ycwn/yatabaza/docs/schematics/yatabaza-cpu.pdf

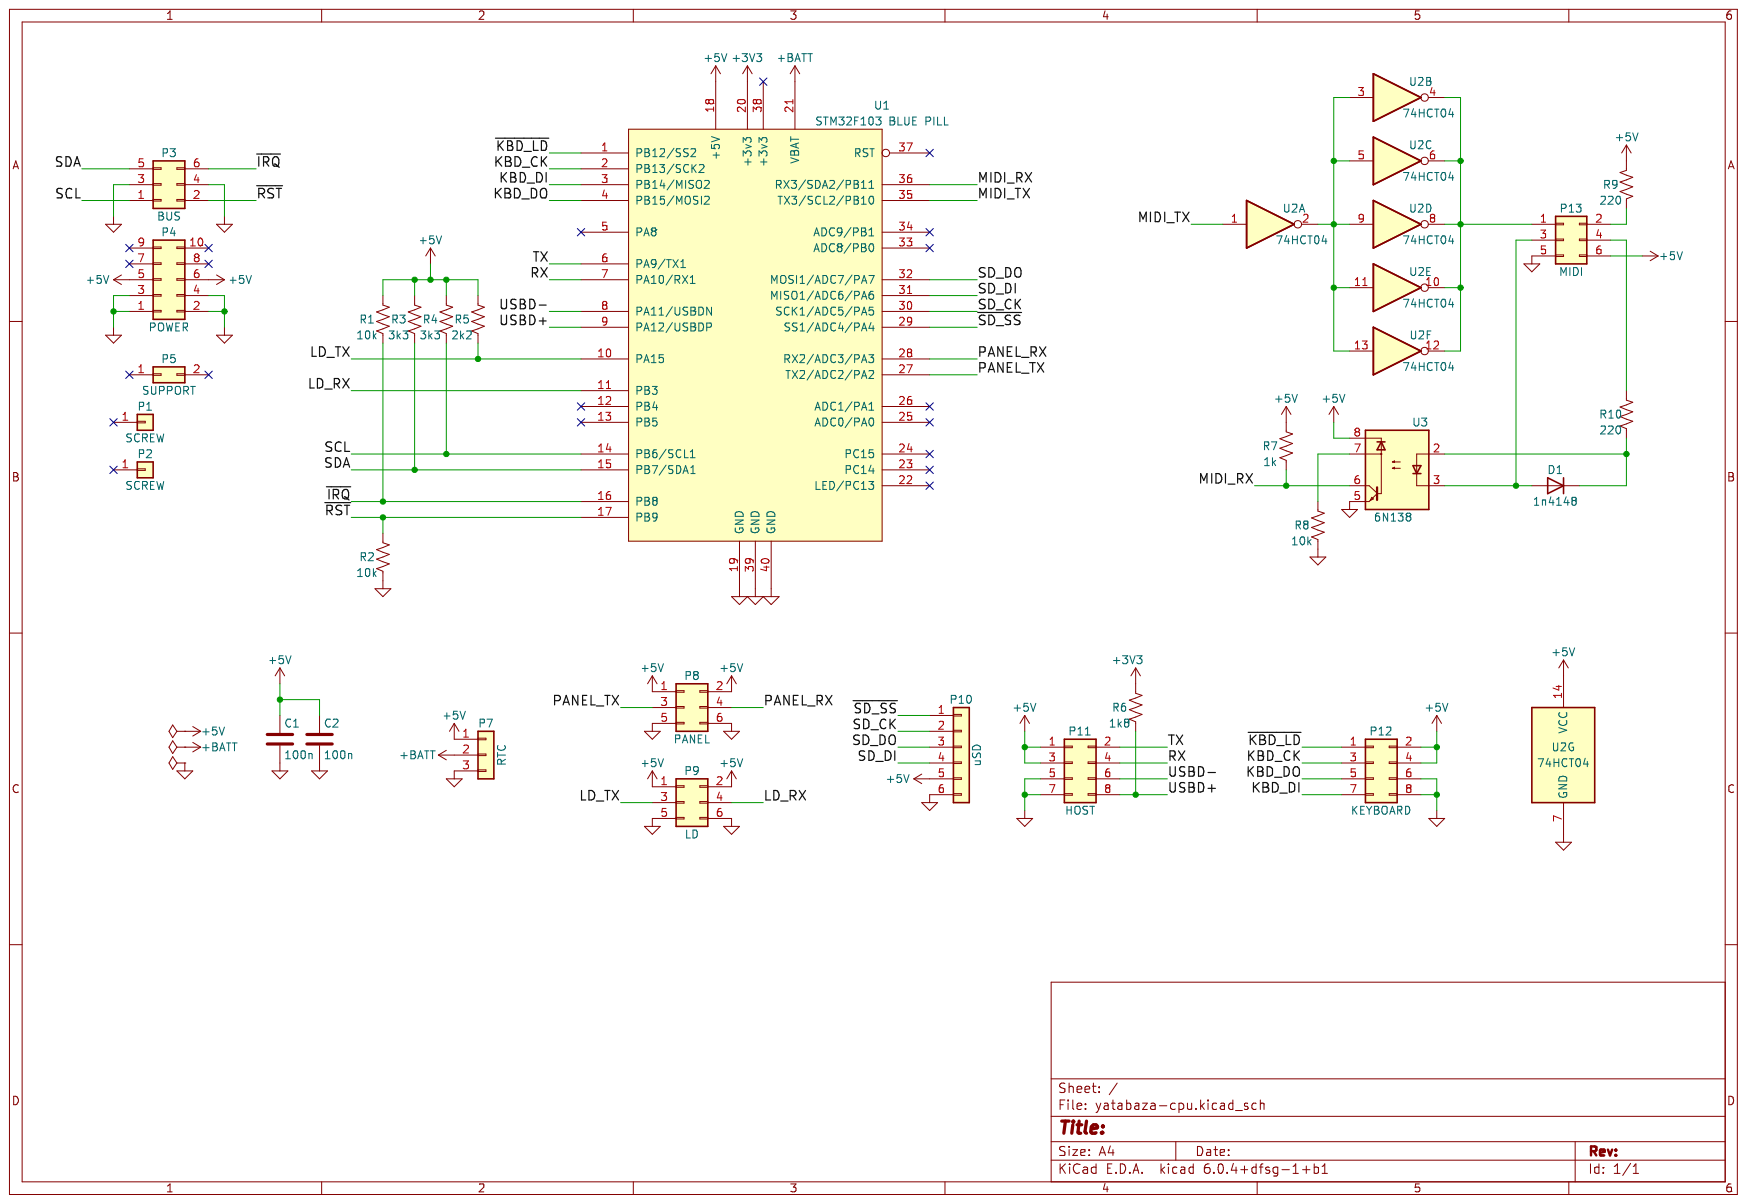
[picture p1: page 1]
