ycwn/yatabaza/docs/schematics/yatabaza-power.pdf

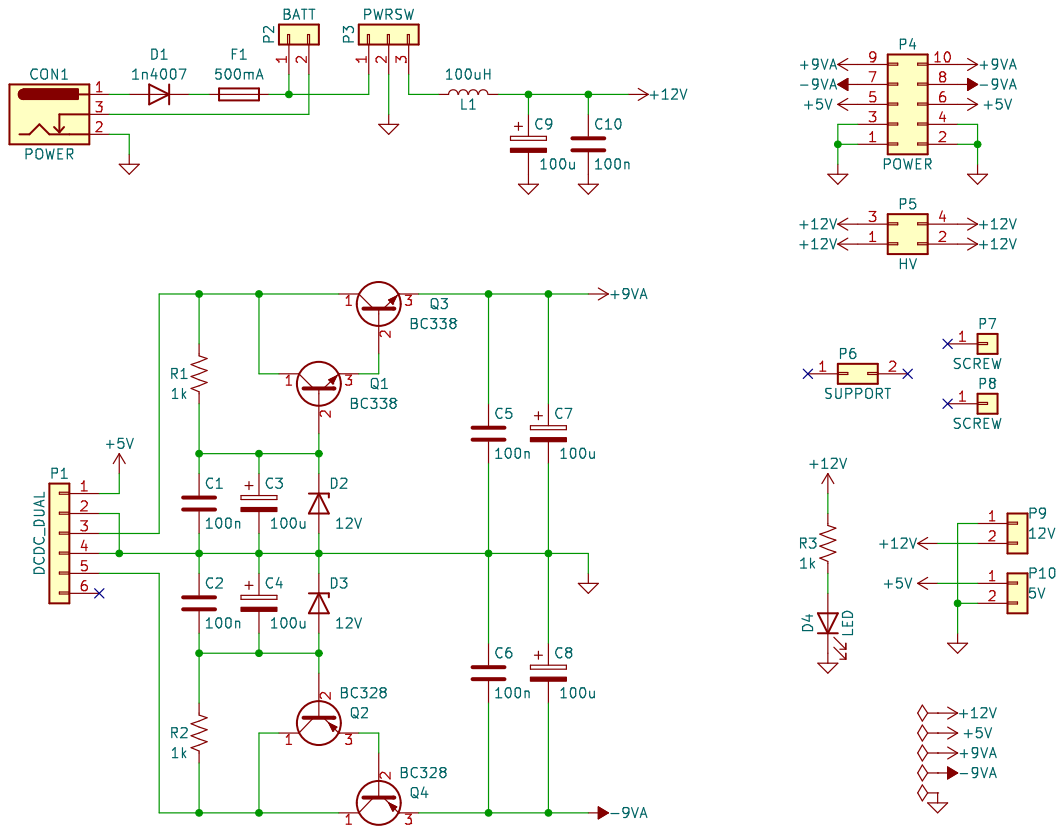
[picture p2: page 1]
