ycwn/yatabaza/docs/schematics/yatabaza-synth.pdf

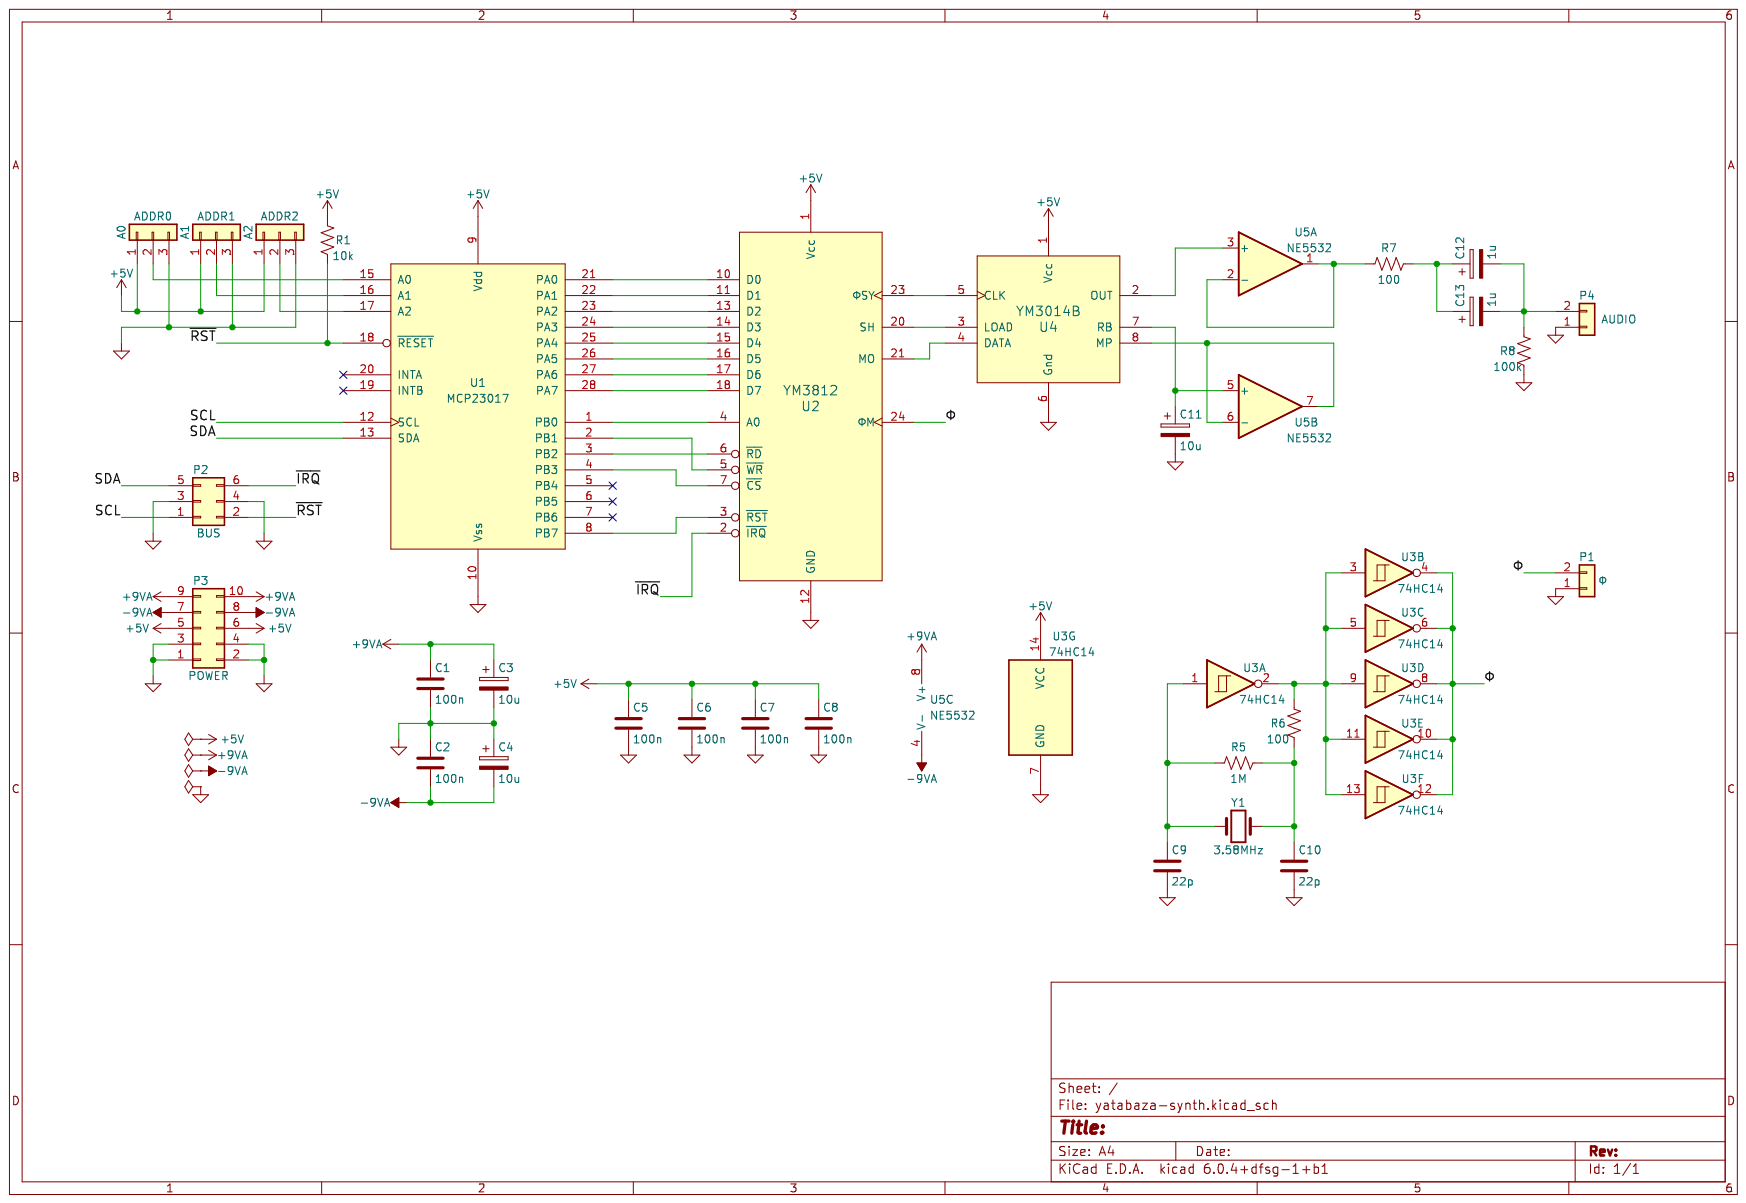
[picture p3: page 1]
