ycwn/yatabaza/docs/schematics/yatabaza-keyboard.pdf

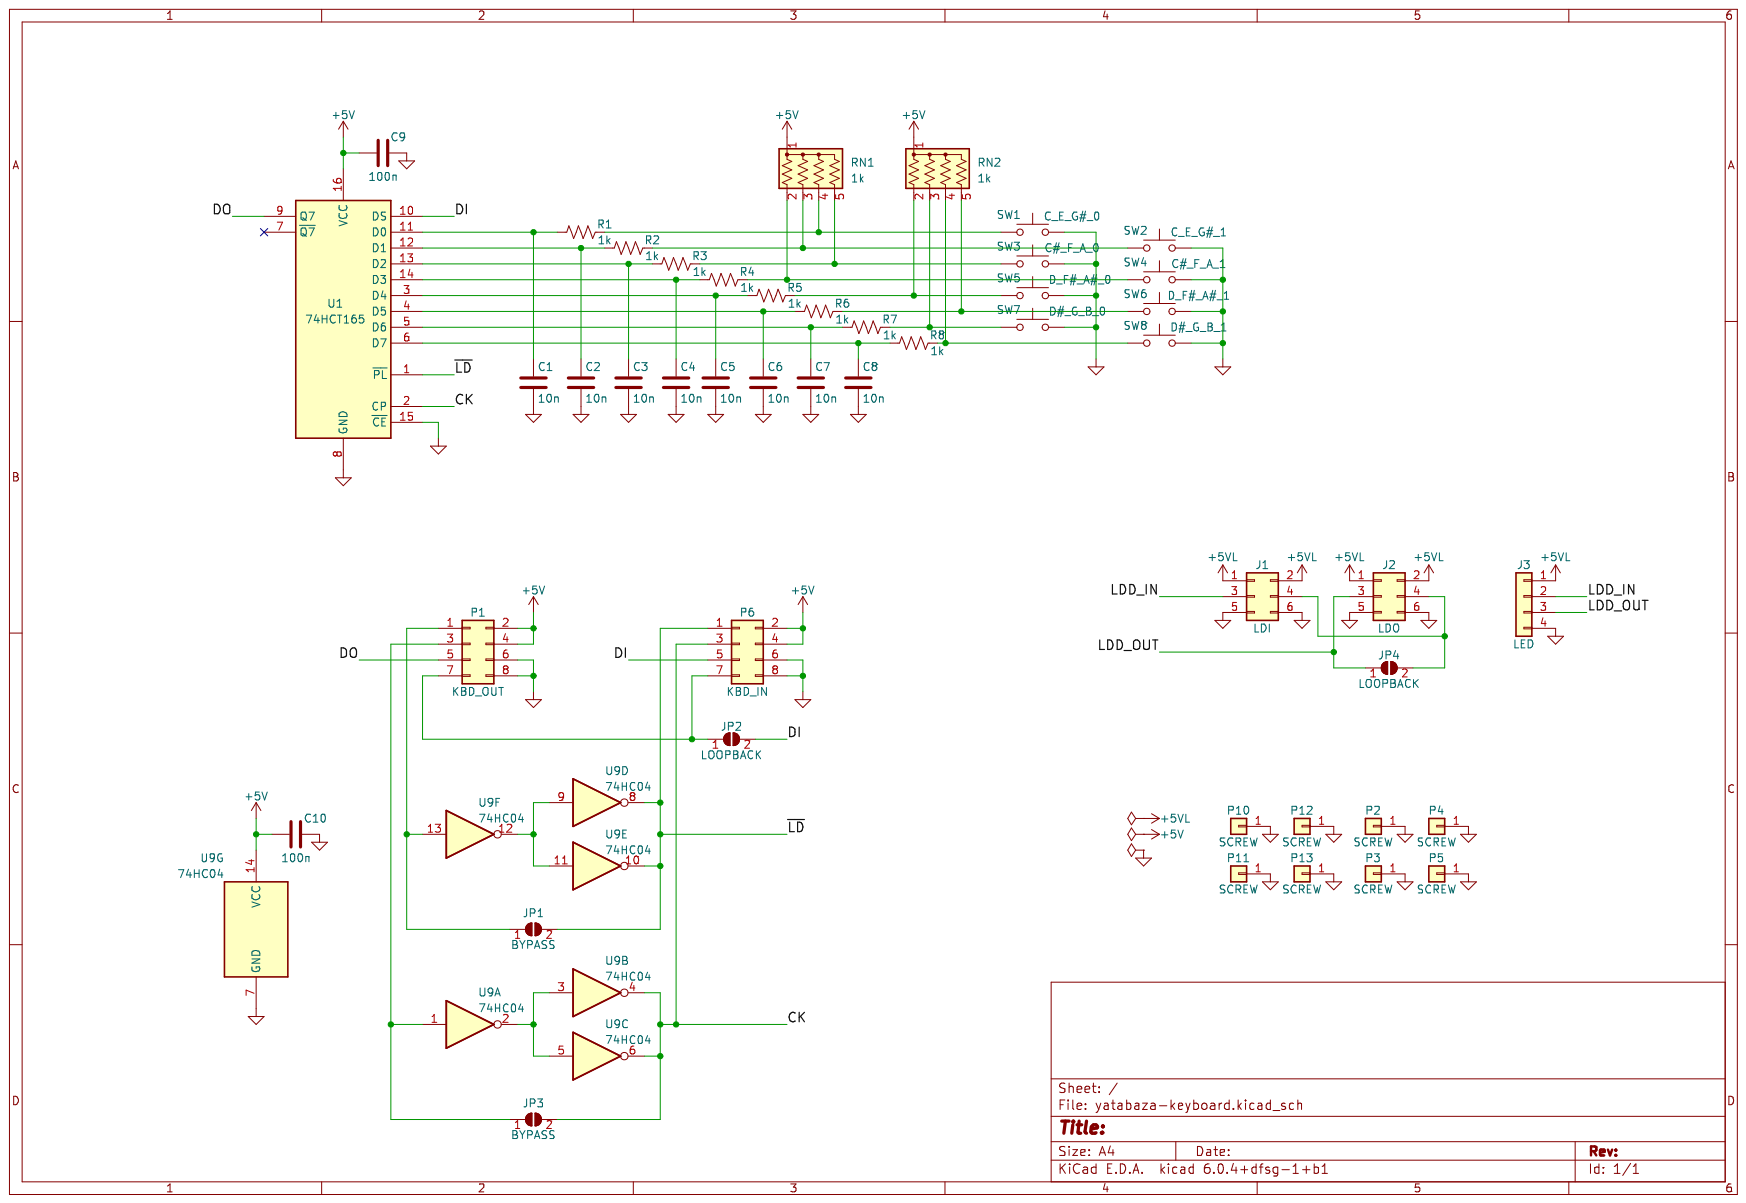
[picture p4: page 1]
