ycwn/yatabaza/docs/schematics/yatabaza-amp.pdf

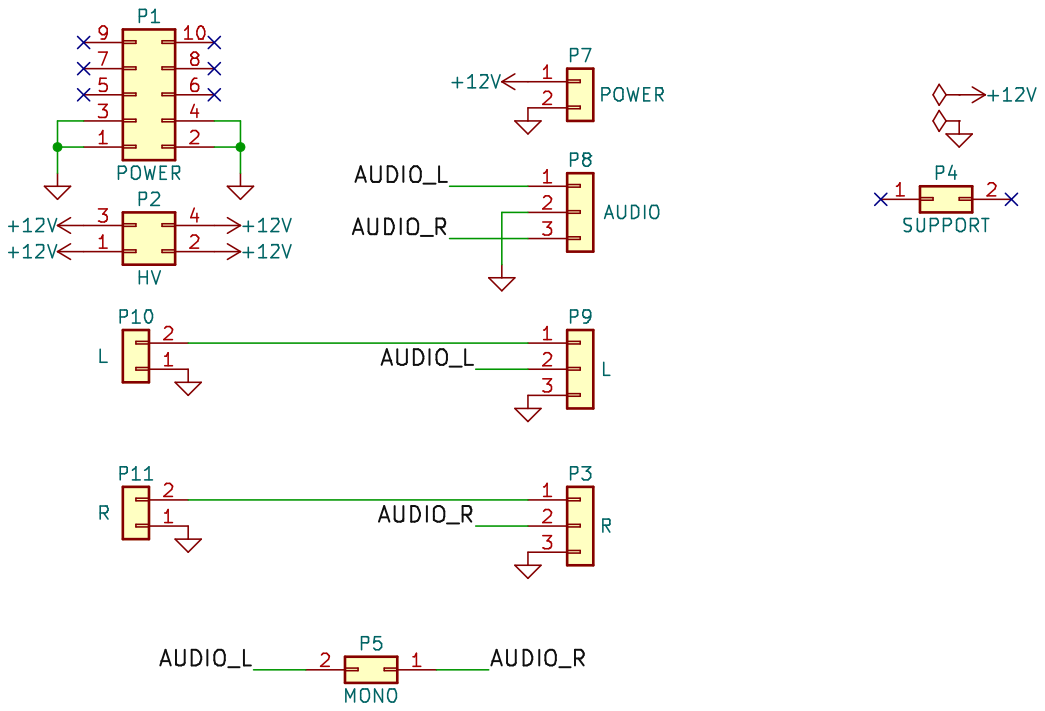
[picture p5: page 1]
