ycwn/yatabaza/docs/schematics/yatabaza-bus.pdf

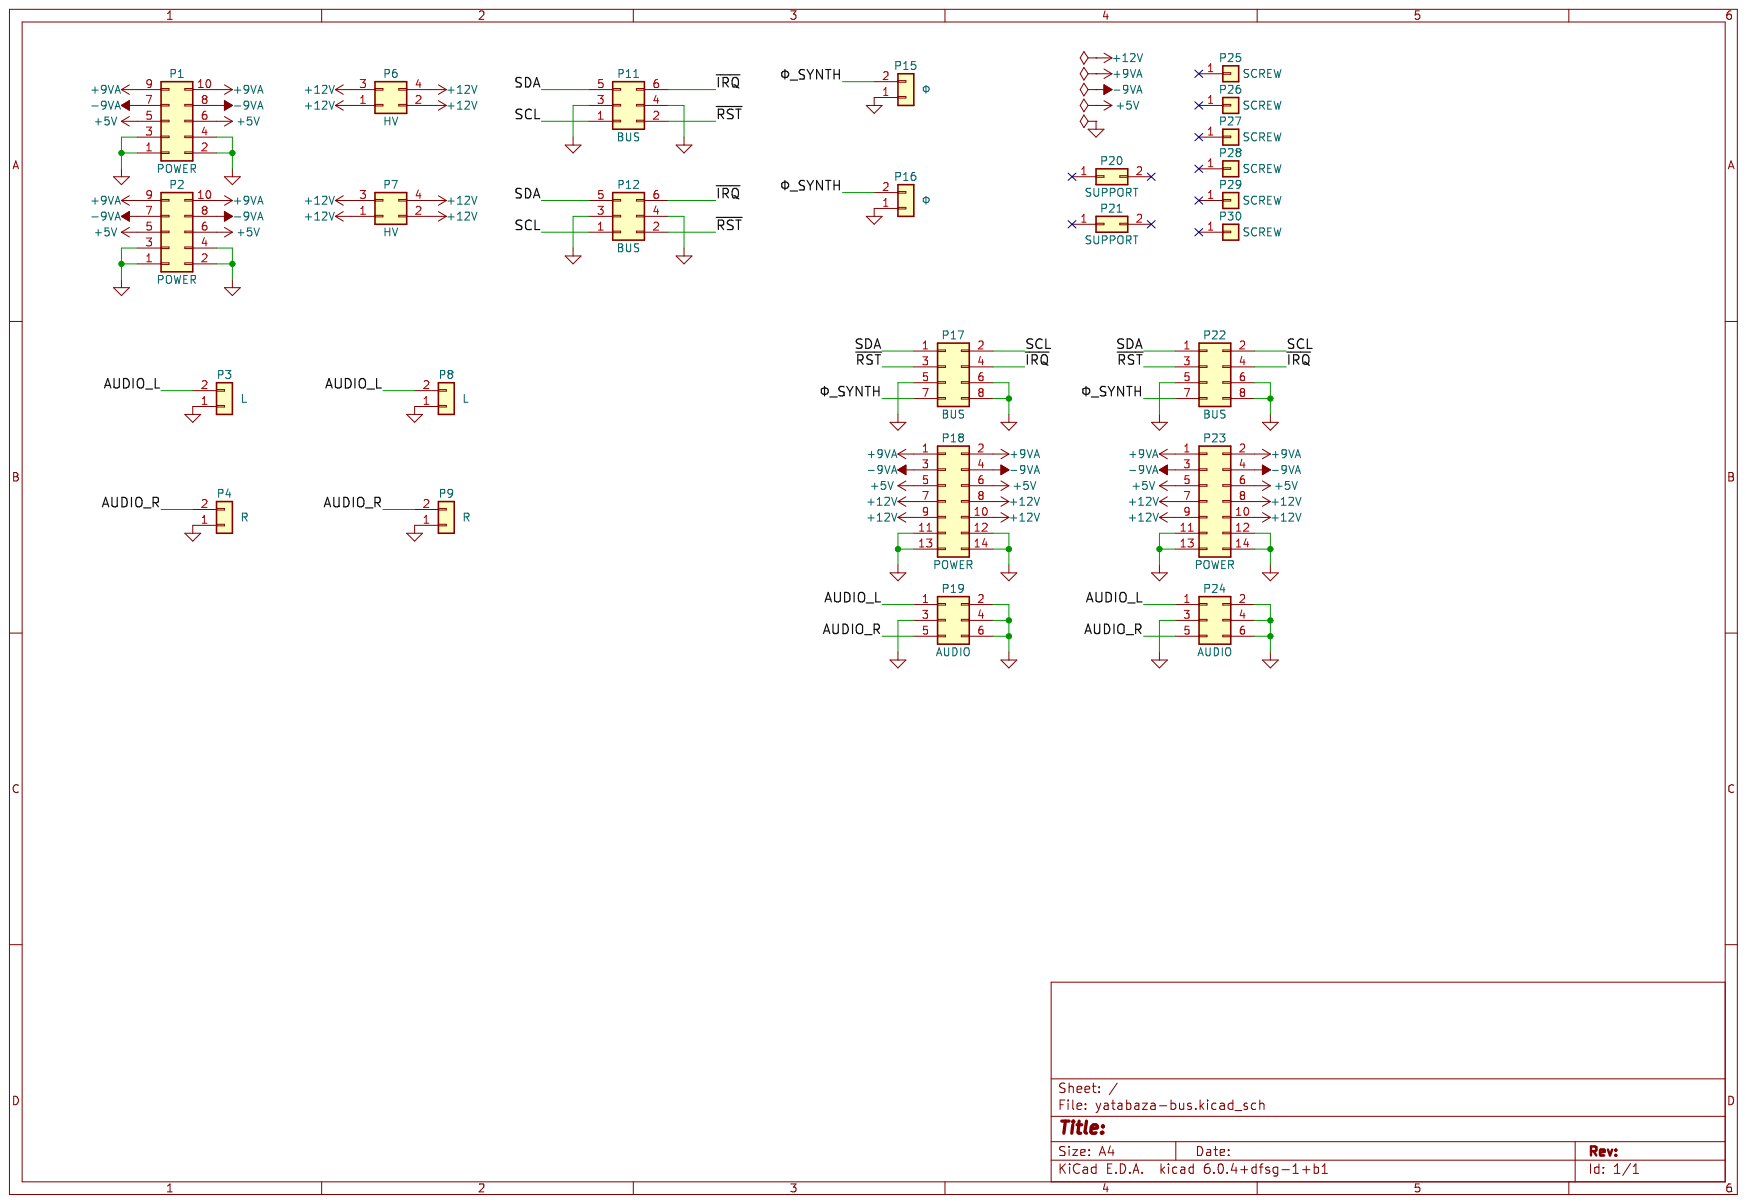
[picture p6: page 1]
