ycwn/yatabaza/hardware/keyboard/yatabaza-keyboard.kicad_pcb

## KiCad design hardware/keyboard/yatabaza-keyboard.kicad_pcb (2022-05-02)

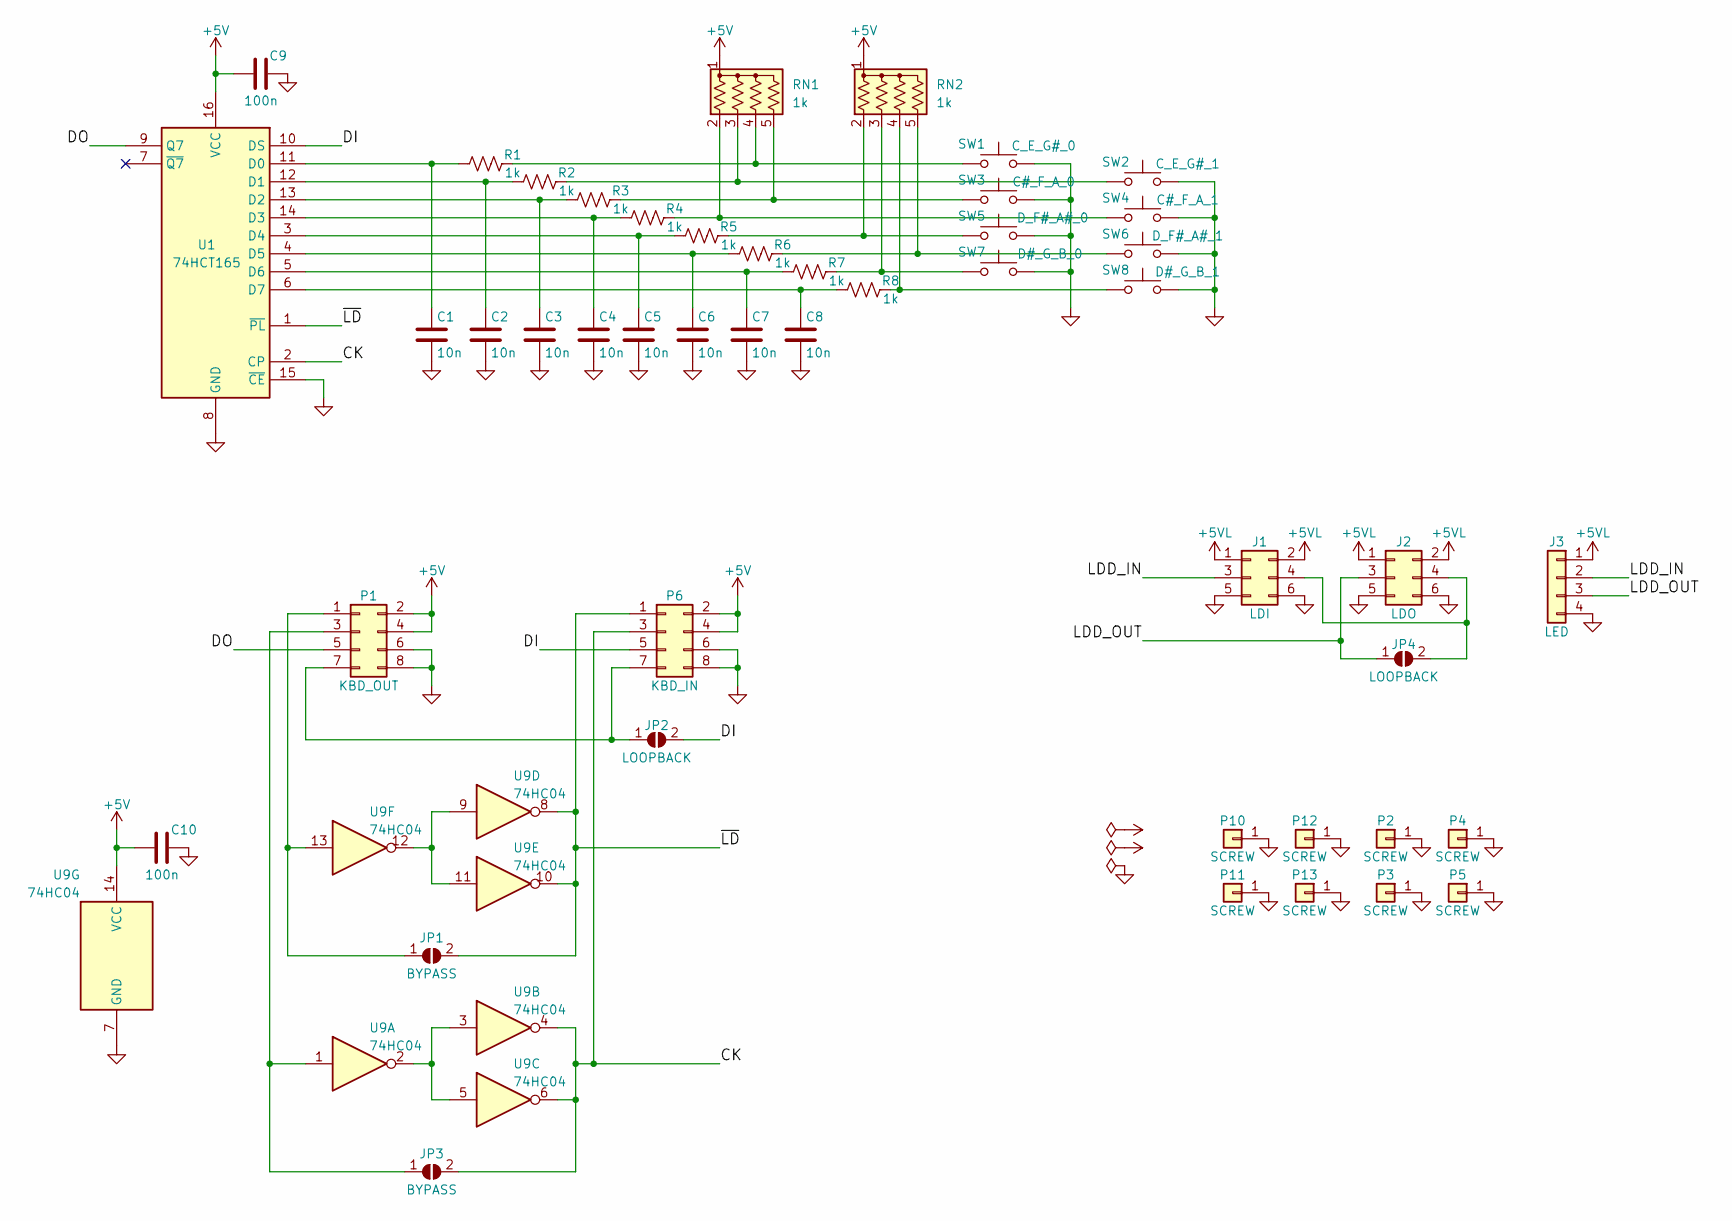
[picture p7: schematic yatabaza-keyboard.kicad_sch]

Parts:
C1, C2, C3, C4, C5, C6, C7, C8: 10n; C_Disc_D3.0mm_W1.6mm_P2.50mm
C9, C10: 100n; C_Disc_D3.0mm_W1.6mm_P2.50mm
J1: LDI; PinHeader_2x03_P2.54mm_Vertical
J2: LDO; PinHeader_2x03_P2.54mm_Vertical
J3: LED; PinHeader_1x04_P2.54mm_Vertical
JP1, JP3: BYPASS; SolderJumper-2_P1.3mm_Open_Pad1.0x1.5mm
JP2, JP4: LOOPBACK; SolderJumper-2_P1.3mm_Open_Pad1.0x1.5mm
P1: KBD_OUT; PinHeader_2x04_P2.54mm_Vertical
P2, P3, P4, P5, P10, P11, P12, P13: SCREW; MountingHole_3.5mm_Pad
P6: KBD_IN; PinHeader_2x04_P2.54mm_Vertical
R1, R2, R3, R4, R5, R6, R7, R8: 1k; R_Axial_DIN0204_L3.6mm_D1.6mm_P2.54mm_Vertical
RN1, RN2: 1k; R_Array_SIP5
SW1: C_E_G#_0; SW_PUSH-12mm
SW2: C_E_G#_1; SW_PUSH-12mm
SW3: C#_F_A_0; SW_PUSH-12mm
SW4: C#_F_A_1; SW_PUSH-12mm
SW5: D_F#_A#_0; SW_PUSH-12mm
SW6: D_F#_A#_1; SW_PUSH-12mm
SW7: D#_G_B_0; SW_PUSH-12mm
SW8: D#_G_B_1; SW_PUSH-12mm
U1: 74HCT165; DIP-16_W7.62mm
U9: 74HC04; DIP-14_W7.62mm

Connections:
+5V: C9.1, C10.1, P1.2, P1.4, P6.2, P6.4, RN1.1 (common), RN2.1 (common), U1.16 (VCC), U9.14 (VCC)
+5VL: J1.1, J1.2, J2.1, J2.2, J3.1
/CK: JP3.2 (B), P6.3, U1.2 (CP), U9.4, U9.6
/DI: JP2.2 (B), P6.5, U1.10 (DS)
/DO: P1.5, U1.9 (Q7)
/LDD_IN: J1.3, J3.2
/LDD_OUT: J2.3, J3.3, JP4.1 (A)
/~LD: JP1.2 (B), P6.1, U1.1 (~PL), U9.8, U9.10
GND: C1.2, C2.2, C3.2, C4.2, C5.2, C6.2, C7.2, C8.2, C9.2, C10.2, J1.5, J1.6, J2.5, J2.6, J3.4, P1.6, P1.8, P2.1, P3.1, P4.1, P5.1, P6.6, P6.8, P10.1, P11.1, P12.1, P13.1, SW1.1, SW2.1, SW3.1, SW4.1, SW5.1, SW6.1, SW7.1, SW8.1, U1.8 (GND), U1.15 (~CE), U9.7 (GND)
unnamed: C1.1, R1.2, U1.11 (D0)
unnamed: C2.1, R2.2, U1.12 (D1)
unnamed: C3.1, R3.2, U1.13 (D2)
unnamed: C4.1, R4.2, U1.14 (D3)
unnamed: C5.1, R5.2, U1.3 (D4)
unnamed: C6.1, R6.2, U1.4 (D5)
unnamed: C7.1, R7.2, U1.5 (D6)
unnamed: C8.1, R8.2, U1.6 (D7)
unnamed: J1.4, J2.4, JP4.2 (B)
unnamed: JP1.1 (A), P1.1, U9.13
unnamed: JP2.1 (A), P1.7, P6.7
unnamed: JP3.1 (A), P1.3, U9.1
unnamed: R1.1, RN1.4 (R3), SW1.2
unnamed: R2.1, RN1.3 (R2), SW2.2
unnamed: R3.1, RN1.5 (R4), SW3.2
unnamed: R4.1, RN1.2 (R1), SW4.2
unnamed: R5.1, RN2.2 (R1), SW5.2
unnamed: R6.1, RN2.5 (R4), SW6.2
unnamed: R7.1, RN2.3 (R2), SW7.2
unnamed: R8.1, RN2.4 (R3), SW8.2
unnamed: U9.2, U9.3, U9.5
unnamed: U9.9, U9.11, U9.12

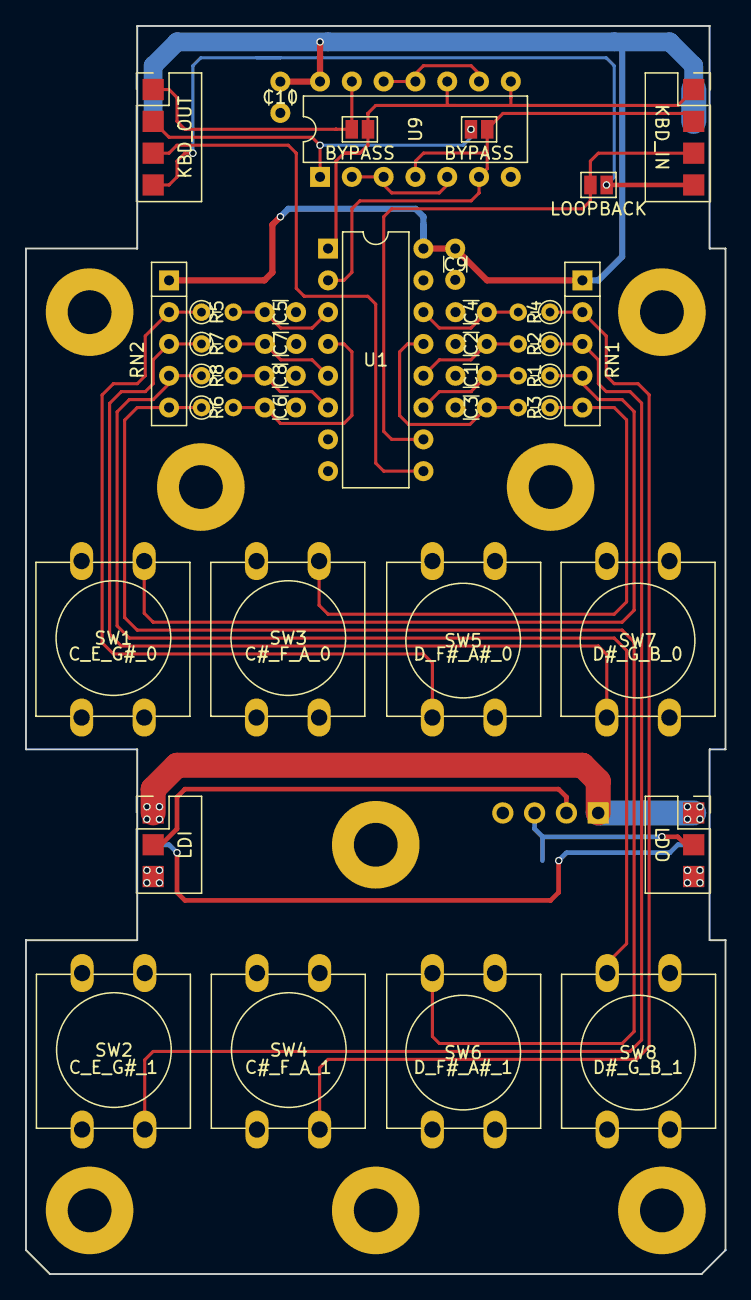
[picture p8: board yatabaza-keyboard.kicad_pcb from above]

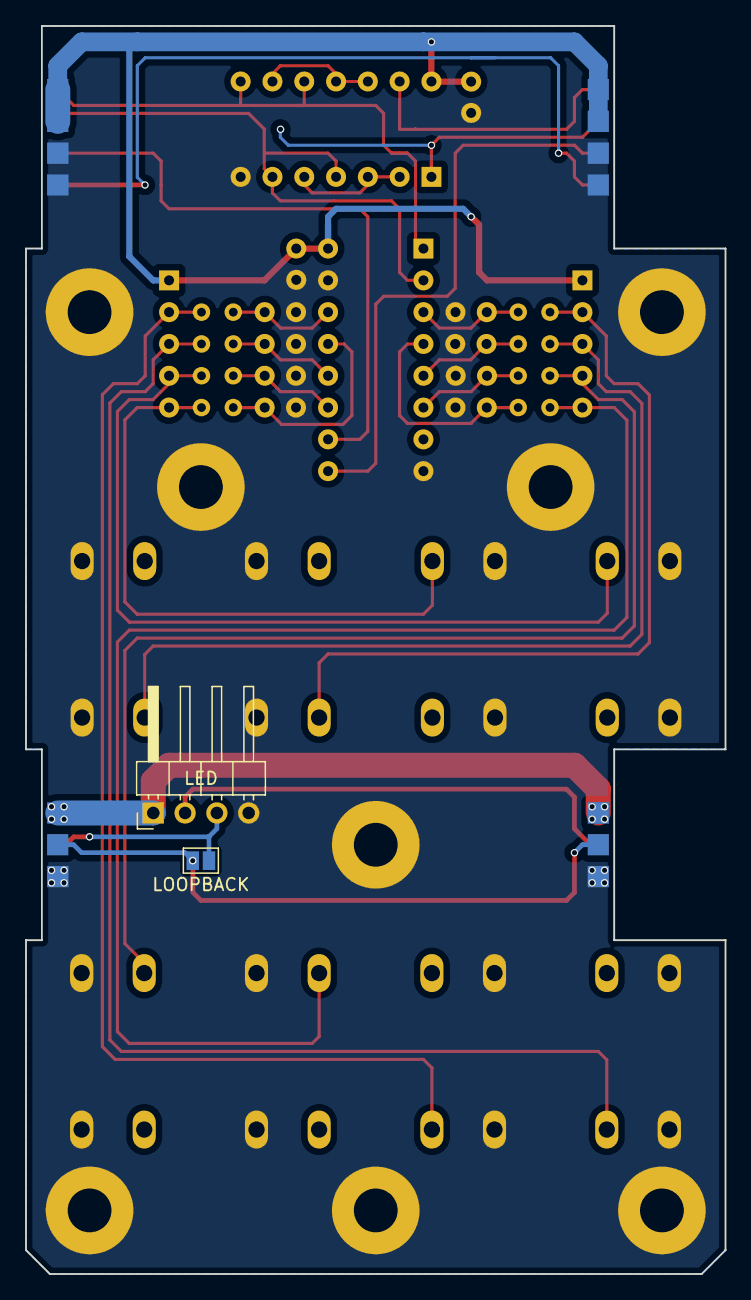
[picture p9: board yatabaza-keyboard.kicad_pcb from below]

Board: 2 copper layers, 55.9 x 99.7 mm, 47 parts (2 on the bottom side), 31 nets.
