ycwn/yatabaza/hardware/amp/yatabaza-amp.kicad_pcb

## KiCad design hardware/amp/yatabaza-amp.kicad_pcb (2022-04-23)

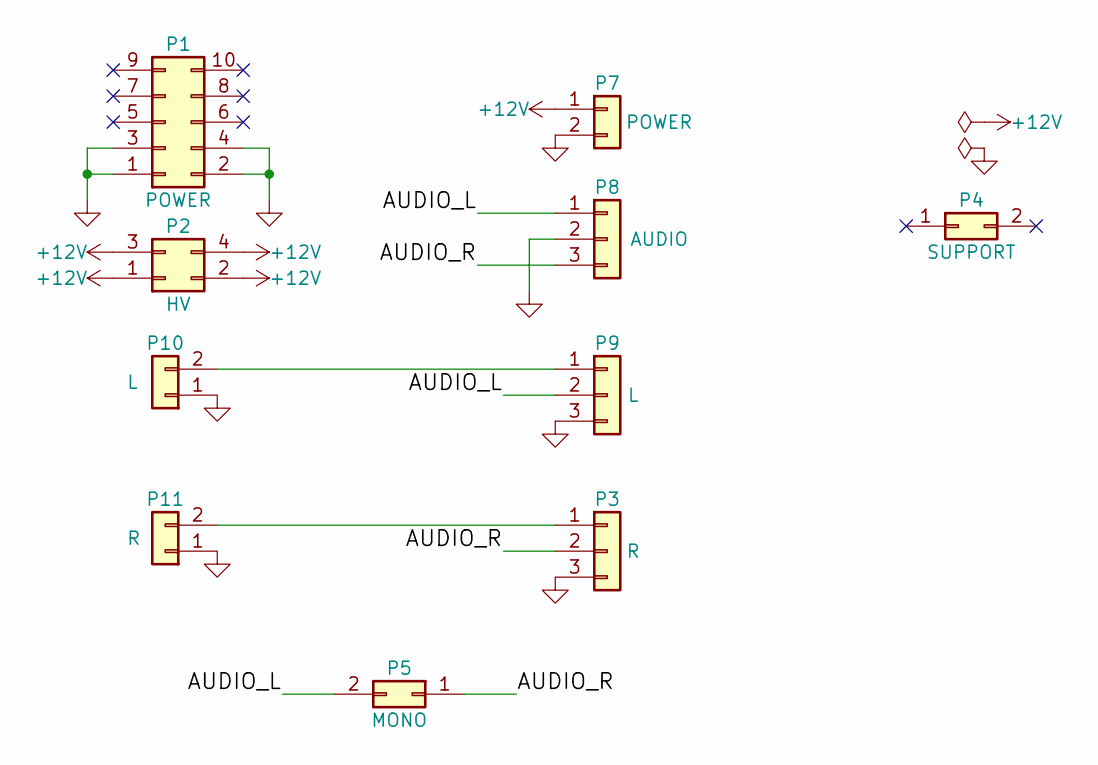
[picture p10: schematic yatabaza-amp.kicad_sch]

Parts:
P1: POWER; PinHeader_2x05_P2.54mm_Vertical
P2: HV; PinHeader_2x02_P2.54mm_Vertical
P3: R; PinHeader_1x03_P2.54mm_Vertical
P4: SUPPORT; PinHeader_2x01_P2.54mm_Vertical
P5: MONO; SolderJumper-2_P1.3mm_Open_Pad1.0x1.5mm
P7: POWER; PinHeader_2x01_P2.54mm_Vertical
P8: AUDIO; PinHeader_1x03_P2.54mm_Vertical
P9: L; PinHeader_1x03_P2.54mm_Vertical
P10: L; PinHeader_1x02_P2.54mm_Vertical
P11: R; PinHeader_1x02_P2.54mm_Vertical

Connections:
+12V: P2.1, P2.2, P2.3, P2.4, P7.1
/AUDIO_L: P5.2, P8.1, P9.2
/AUDIO_R: P3.2, P5.1, P8.3
GND: P1.1, P1.2, P1.3, P1.4, P3.3, P7.2, P8.2, P9.3, P10.1, P11.1
unnamed: P3.1, P11.2
unnamed: P9.1, P10.2

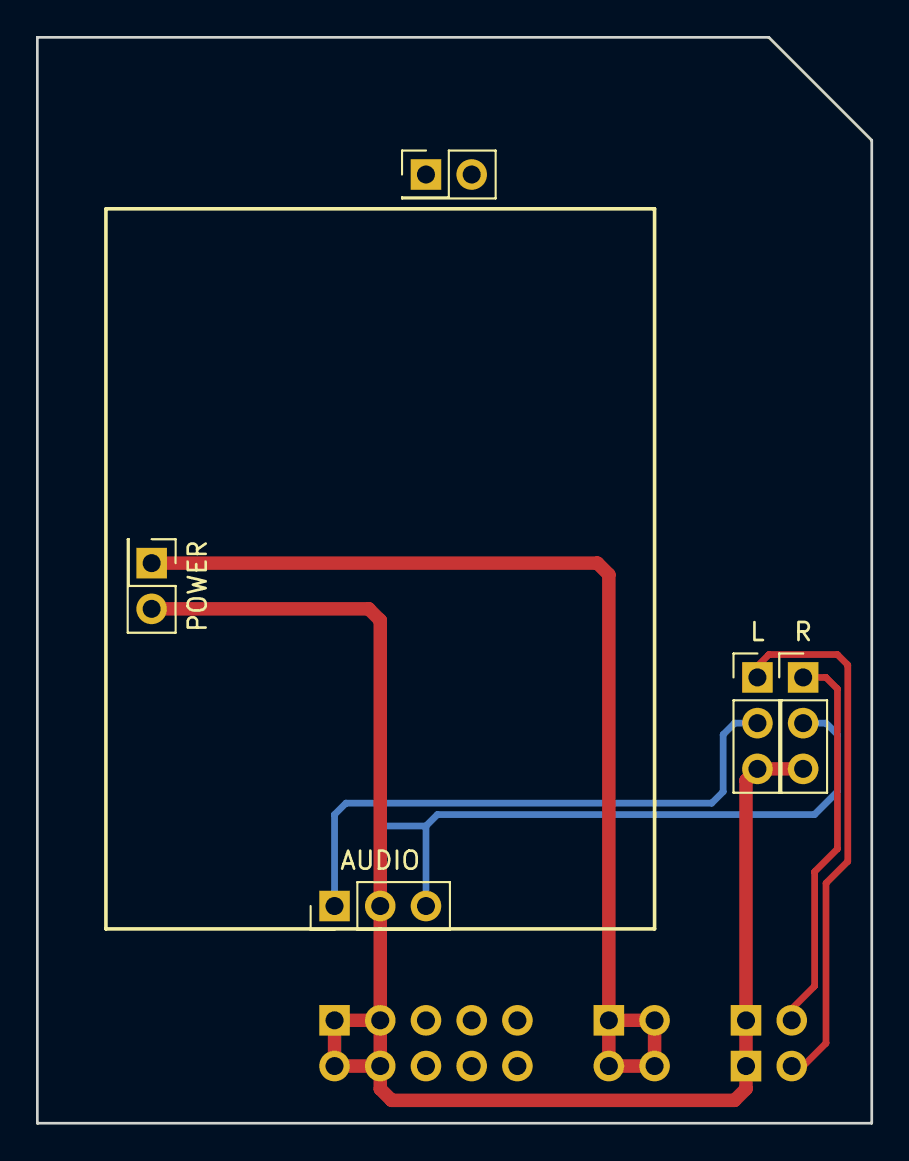
[picture p11: board yatabaza-amp.kicad_pcb from above]

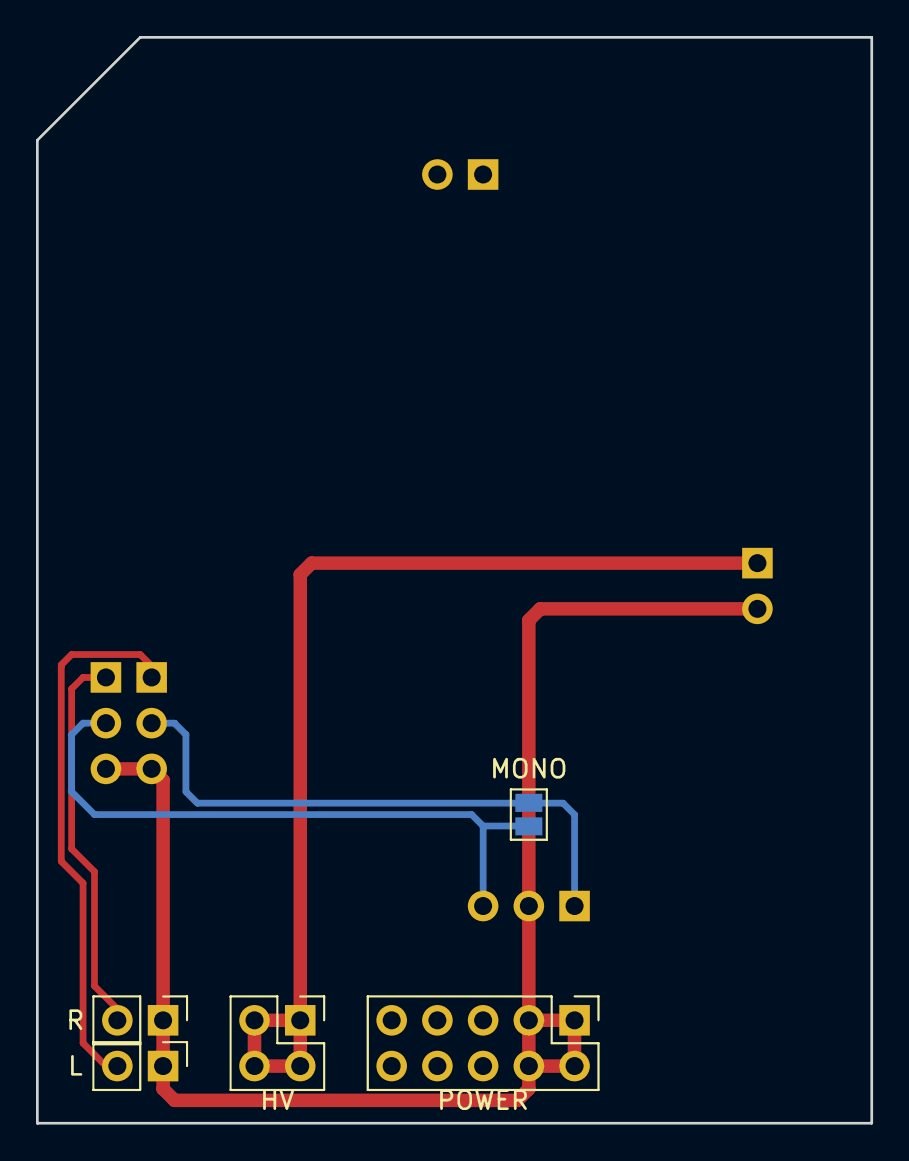
[picture p12: board yatabaza-amp.kicad_pcb from below]

Board: 2 copper layers, 46.4 x 60.3 mm, 10 parts (5 on the bottom side), 6 nets.
