ycwn/yatabaza/hardware/bus/yatabaza-bus.kicad_pcb

## KiCad design hardware/bus/yatabaza-bus.kicad_pcb (2022-04-23)

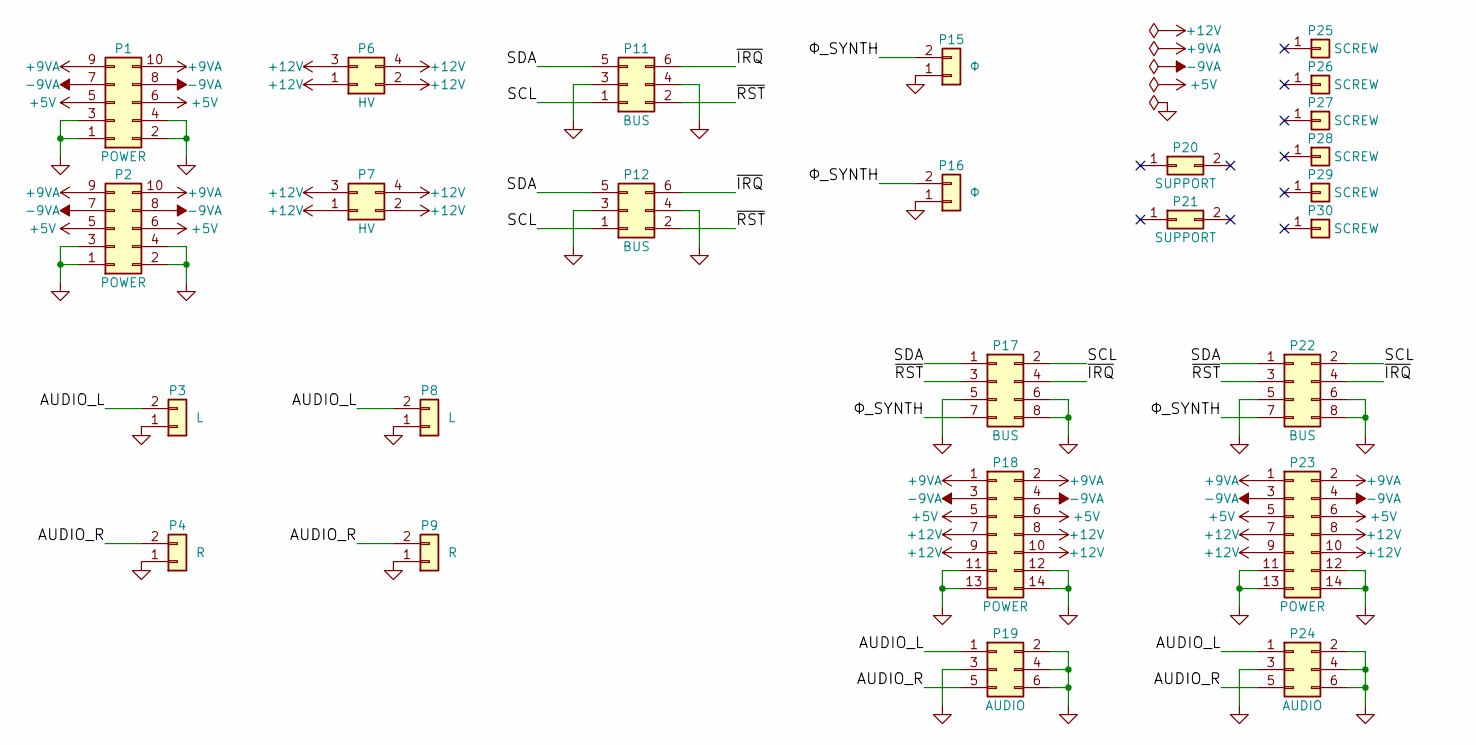
[picture p13: schematic yatabaza-bus.kicad_sch]

Parts:
P1, P2: POWER; PinHeader_2x05_P2.54mm_Vertical
P3, P8: L; PinHeader_1x02_P2.54mm_Vertical
P4, P9: R; PinHeader_1x02_P2.54mm_Vertical
P6, P7: HV; PinHeader_2x02_P2.54mm_Vertical
P11, P12: BUS; PinHeader_2x03_P2.54mm_Vertical
P15, P16: Φ; PinHeader_1x02_P2.54mm_Vertical
P17, P22: BUS; PinHeader_2x04_P2.54mm_Vertical
P18, P23: POWER; PinHeader_2x07_P2.54mm_Vertical
P19, P24: AUDIO; PinHeader_2x03_P2.54mm_Vertical
P20, P21: SUPPORT; PinHeader_1x02_P2.54mm_Vertical
P25, P26, P27, P28, P29, P30: SCREW; MountingHole_2.7mm_M2.5_ISO14580_Pad

Connections:
+5V: P1.5, P1.6, P2.5, P2.6, P18.5, P18.6, P23.5, P23.6
+9VA: P1.9, P1.10, P2.9, P2.10, P18.1, P18.2, P23.1, P23.2
+12V: P6.1, P6.2, P6.3, P6.4, P7.1, P7.2, P7.3, P7.4, P18.7, P18.8, P18.9, P18.10, P23.7, P23.8, P23.9, P23.10
-9VA: P1.7, P1.8, P2.7, P2.8, P18.3, P18.4, P23.3, P23.4
/AUDIO_L: P3.2, P8.2, P19.1, P24.1
/AUDIO_R: P4.2, P9.2, P19.5, P24.5
/SCL: P11.1, P12.1, P17.2, P22.2
/SDA: P11.5, P12.5, P17.1, P22.1
/~IRQ: P11.6, P12.6, P17.4, P22.4
/~RST: P11.2, P12.2, P17.3, P22.3
/Φ_SYNTH: P15.2, P16.2, P17.7, P22.7
GND: P1.1, P1.2, P1.3, P1.4, P2.1, P2.2, P2.3, P2.4, P3.1, P4.1, P8.1, P9.1, P11.3, P11.4, P12.3, P12.4, P15.1, P16.1, P17.5, P17.6, P17.8, P18.11, P18.12, P18.13, P18.14, P19.2, P19.3, P19.4, P19.6, P22.5, P22.6, P22.8, P23.11, P23.12, P23.13, P23.14, P24.2, P24.3, P24.4, P24.6

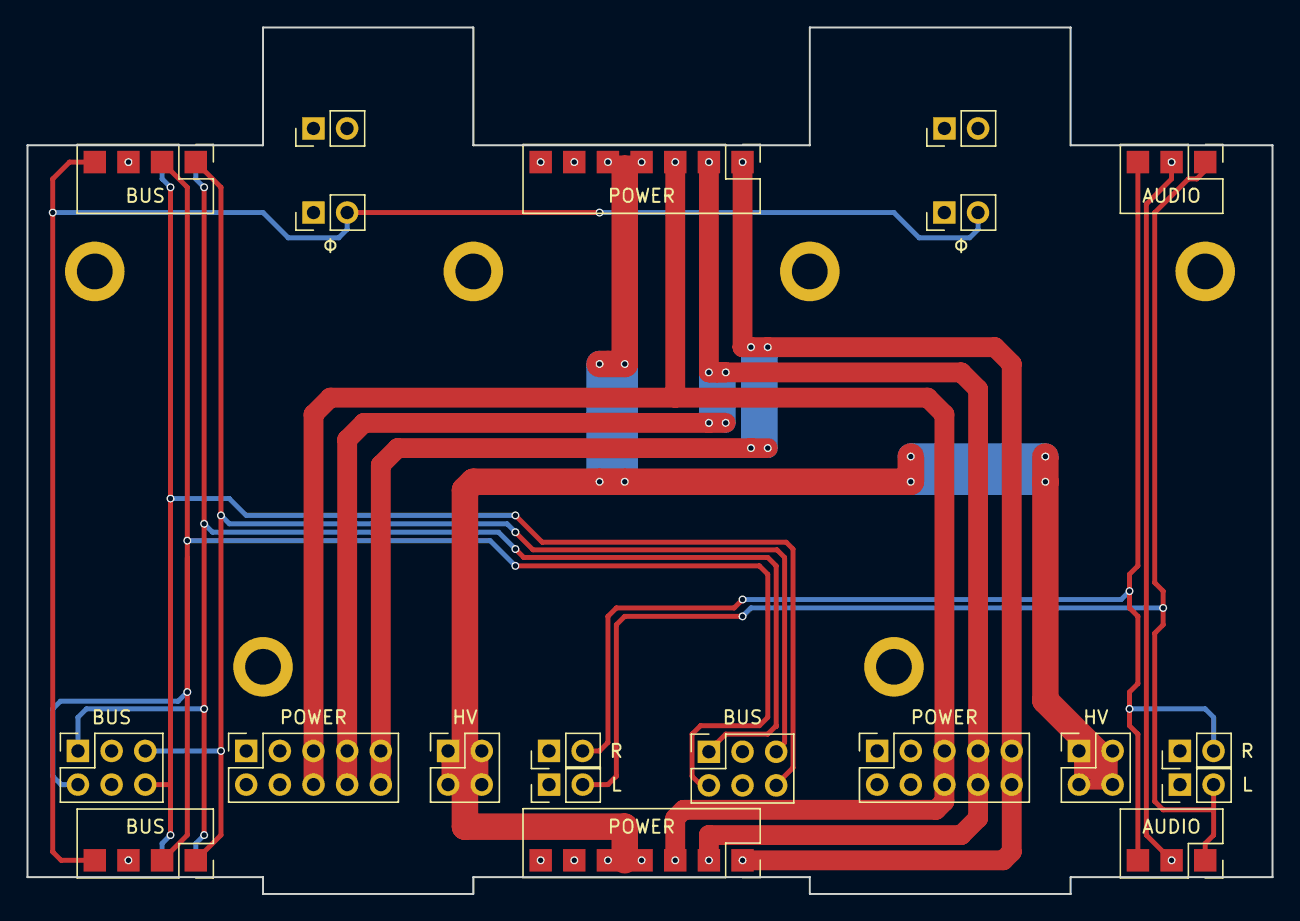
[picture p14: board yatabaza-bus.kicad_pcb from above]

Board: 2 copper layers, 94.0 x 65.4 mm, 26 parts (0 on the bottom side), 12 nets.
