ycwn/yatabaza/hardware/synth/yatabaza-synth.kicad_pcb

## KiCad design hardware/synth/yatabaza-synth.kicad_pcb (2022-04-23)

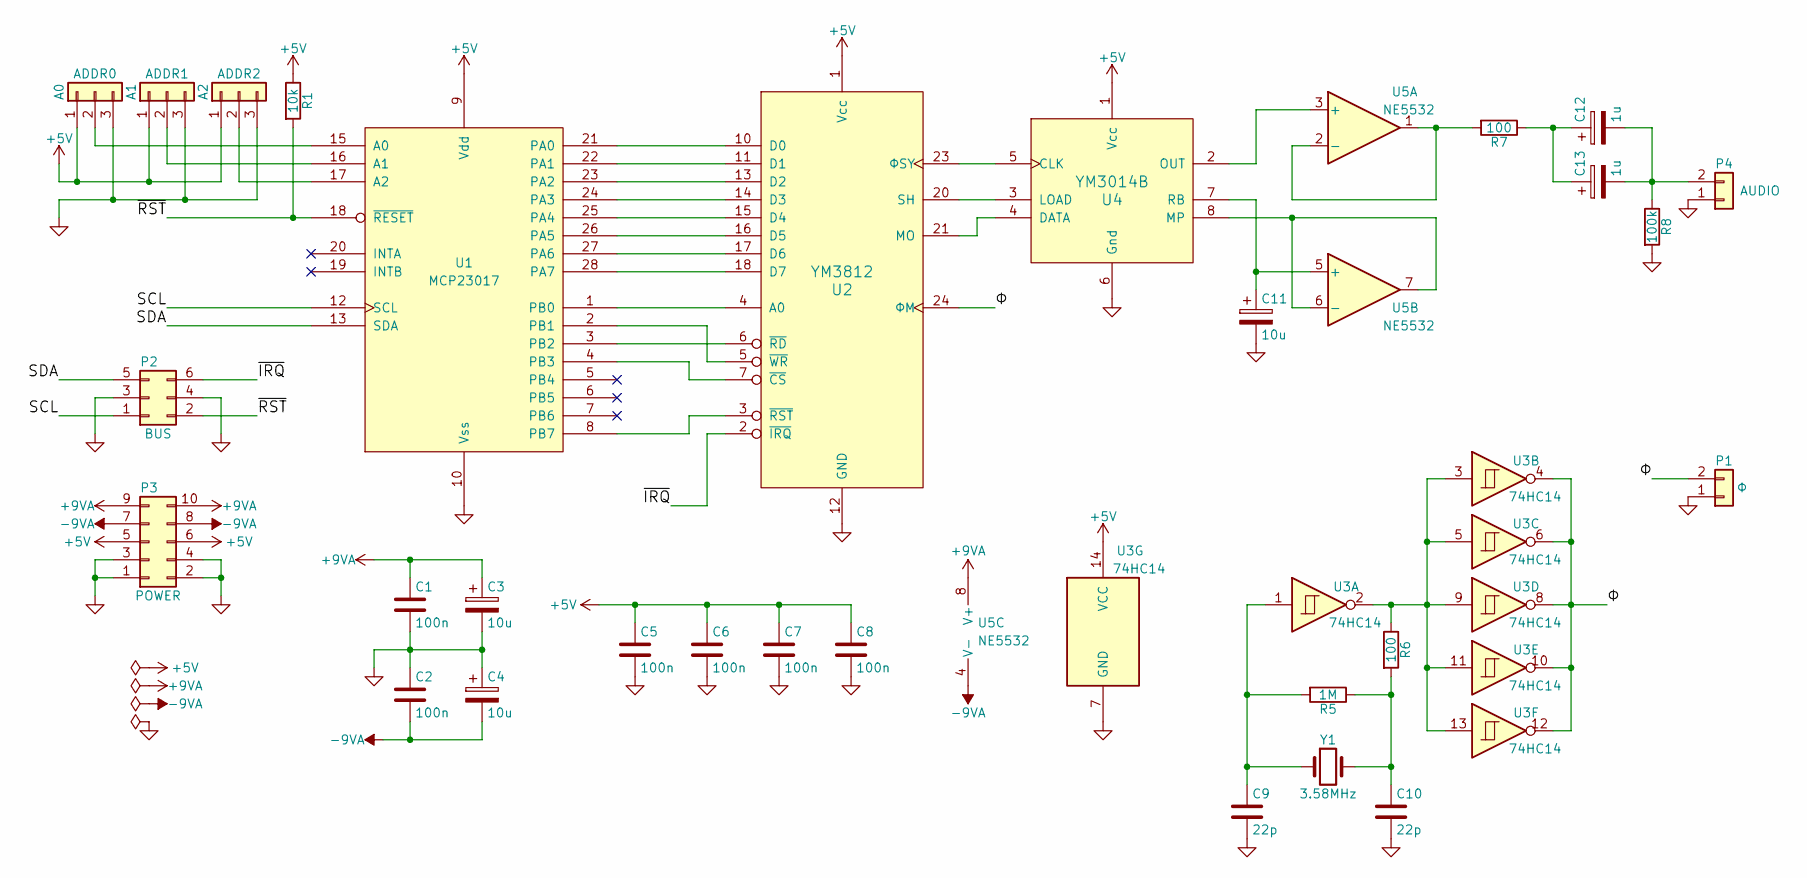
[picture p15: schematic yatabaza-synth.kicad_sch]

Parts:
A0: ADDR0; SolderJumper-3_P1.3mm_Open_Pad1.0x1.5mm_NumberLabels
A1: ADDR1; SolderJumper-3_P1.3mm_Open_Pad1.0x1.5mm_NumberLabels
A2: ADDR2; SolderJumper-3_P1.3mm_Open_Pad1.0x1.5mm_NumberLabels
C1, C2, C5, C6, C7, C8: 100n; C_Disc_D3.0mm_W1.6mm_P2.50mm
C3, C4, C11: 10u; CP_Radial_D5.0mm_P2.50mm
C9, C10: 22p; C_Disc_D3.0mm_W1.6mm_P2.50mm
C12, C13: 1u; CP_Radial_D5.0mm_P2.50mm
P1: Φ; PinHeader_1x02_P2.54mm_Vertical
P2: BUS; PinHeader_2x03_P2.54mm_Vertical
P3: POWER; PinHeader_2x05_P2.54mm_Vertical
P4: AUDIO; PinHeader_1x02_P2.54mm_Vertical
R1: 10k; R_Axial_DIN0204_L3.6mm_D1.6mm_P2.54mm_Vertical
R5: 1M; R_Axial_DIN0204_L3.6mm_D1.6mm_P2.54mm_Vertical
R6, R7: 100; R_Axial_DIN0204_L3.6mm_D1.6mm_P2.54mm_Vertical
R8: 100k; R_Axial_DIN0204_L3.6mm_D1.6mm_P2.54mm_Vertical
U1: MCP23017
U2: YM3812
U3: 74HC14; DIP-14_W7.62mm
U4: YM3014B
U5: NE5532; DIP-8_W7.62mm
Y1: 3.58MHz; Crystal_HC49-U_Vertical

Connections:
+5V: A0.1, A1.1, A2.1, C5.1, C6.1, C7.1, C8.1, P3.5, P3.6, R1.1, U1.9 (Vdd), U2.1 (Vcc), U3.14 (VCC), U4.1 (Vcc)
+9VA: C1.1, C3.1, P3.9, P3.10, U5.8 (V+)
-9VA: C2.2, C4.2, P3.7, P3.8, U5.4 (V-)
/SCL: P2.1, U1.12 (SCL)
/SDA: P2.5, U1.13 (SDA)
/~IRQ: P2.6, U2.2 (~IRQ)
/~RST: P2.2, R1.2, U1.18 (~RESET)
/Φ: P1.2, U2.24 (ΦM), U3.4, U3.6, U3.8, U3.10, U3.12
GND: A0.3, A1.3, A2.3, C1.2, C2.1, C3.2, C4.1, C5.2, C6.2, C7.2, C8.2, C9.2, C10.2, C11.2, P1.1, P2.3, P2.4, P3.1, P3.2, P3.3, P3.4, P4.1, R8.2, U1.10 (Vss), U2.12 (GND), U3.7 (GND), U4.6 (Gnd)
unnamed: A0.2, U1.15 (A0)
unnamed: A1.2, U1.16 (A1)
unnamed: A2.2, U1.17 (A2)
unnamed: C9.1, R5.2, U3.1, Y1.1
unnamed: C10.1, R5.1, R6.2, Y1.2
unnamed: C11.1, U4.7 (RB), U5.5 (+)
unnamed: C12.1, C13.1, R7.1
unnamed: C12.2, C13.2, P4.2, R8.1
unnamed: R6.1, U3.2, U3.3, U3.5, U3.9, U3.11, U3.13
unnamed: R7.2, U5.1, U5.2 (-)
unnamed: U1.1 (PB0), U2.4 (A0)
unnamed: U1.2 (PB1), U2.5 (~WR)
unnamed: U1.3 (PB2), U2.6 (~RD)
unnamed: U1.4 (PB3), U2.7 (~CS)
unnamed: U1.8 (PB7), U2.3 (~RST)
unnamed: U1.21 (PA0), U2.10 (D0)
unnamed: U1.22 (PA1), U2.11 (D1)
unnamed: U1.23 (PA2), U2.13 (D2)
unnamed: U1.24 (PA3), U2.14 (D3)
unnamed: U1.25 (PA4), U2.15 (D4)
unnamed: U1.26 (PA5), U2.16 (D5)
unnamed: U1.27 (PA6), U2.17 (D6)
unnamed: U1.28 (PA7), U2.18 (D7)
unnamed: U2.20 (SH), U4.3 (LOAD)
unnamed: U2.21 (MO), U4.4 (DATA)
unnamed: U2.23 (ΦSY), U4.5 (CLK)
unnamed: U4.2 (OUT), U5.3 (+)
unnamed: U4.8 (MP), U5.6 (-), U5.7

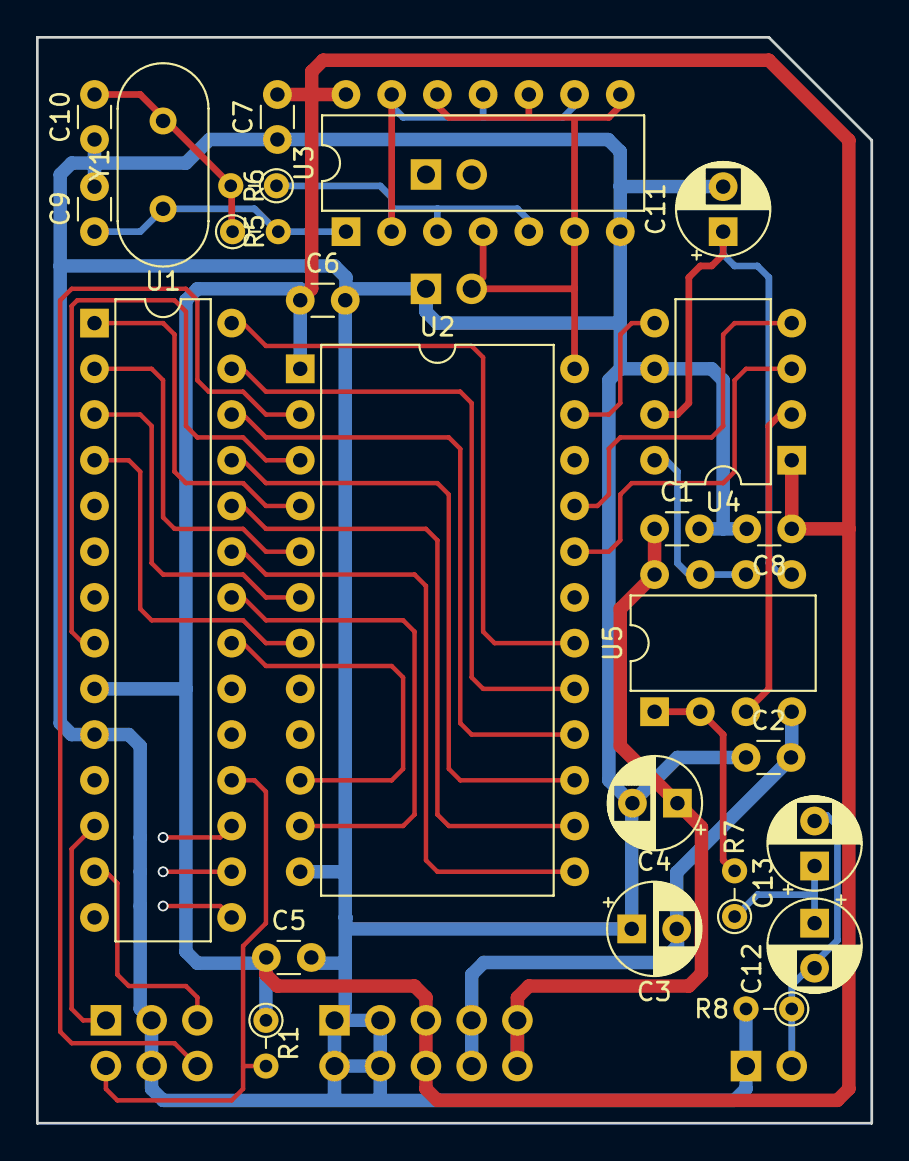
[picture p16: board yatabaza-synth.kicad_pcb from above]

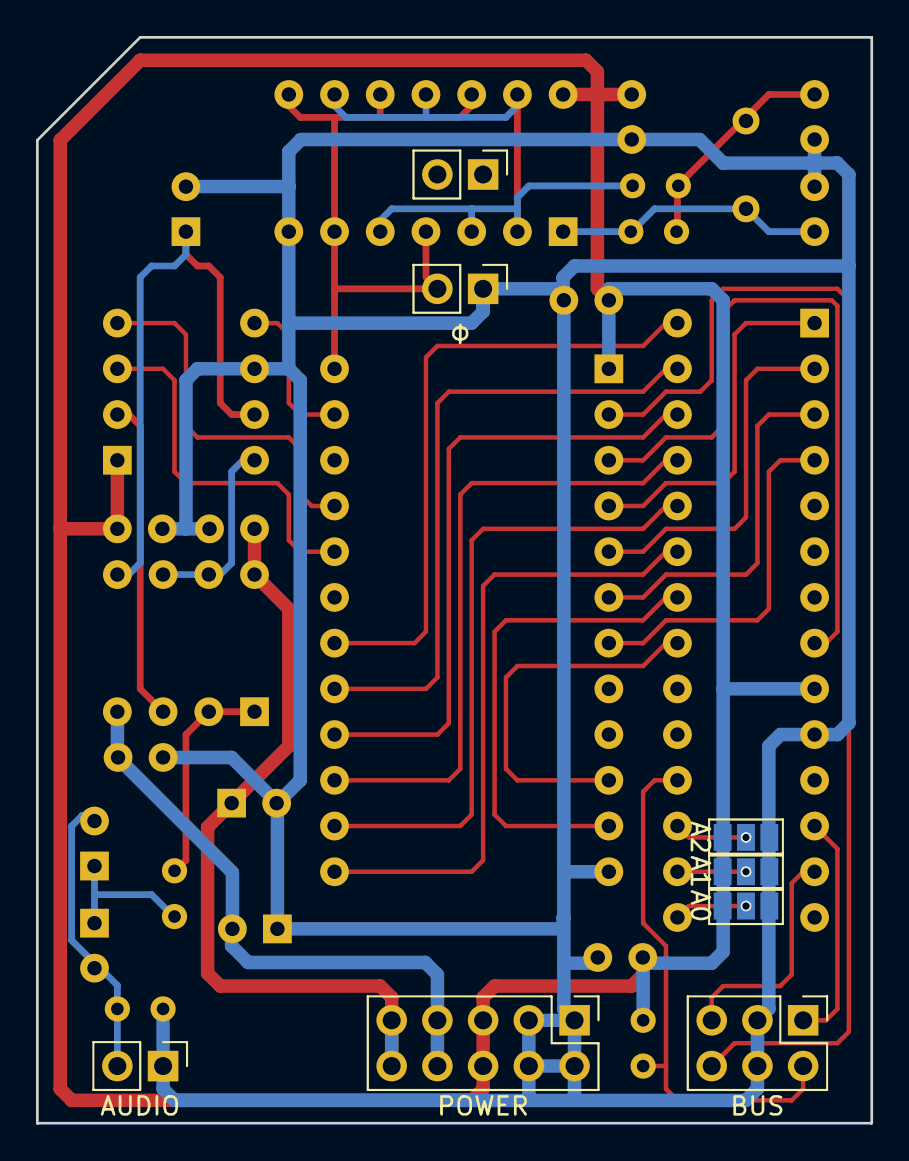
[picture p17: board yatabaza-synth.kicad_pcb from below]

Board: 2 copper layers, 46.4 x 60.3 mm, 31 parts (7 on the bottom side), 37 nets.
