ycwn/yatabaza/hardware/power/yatabaza-power.kicad_pcb

## KiCad design hardware/power/yatabaza-power.kicad_pcb (2022-04-23)

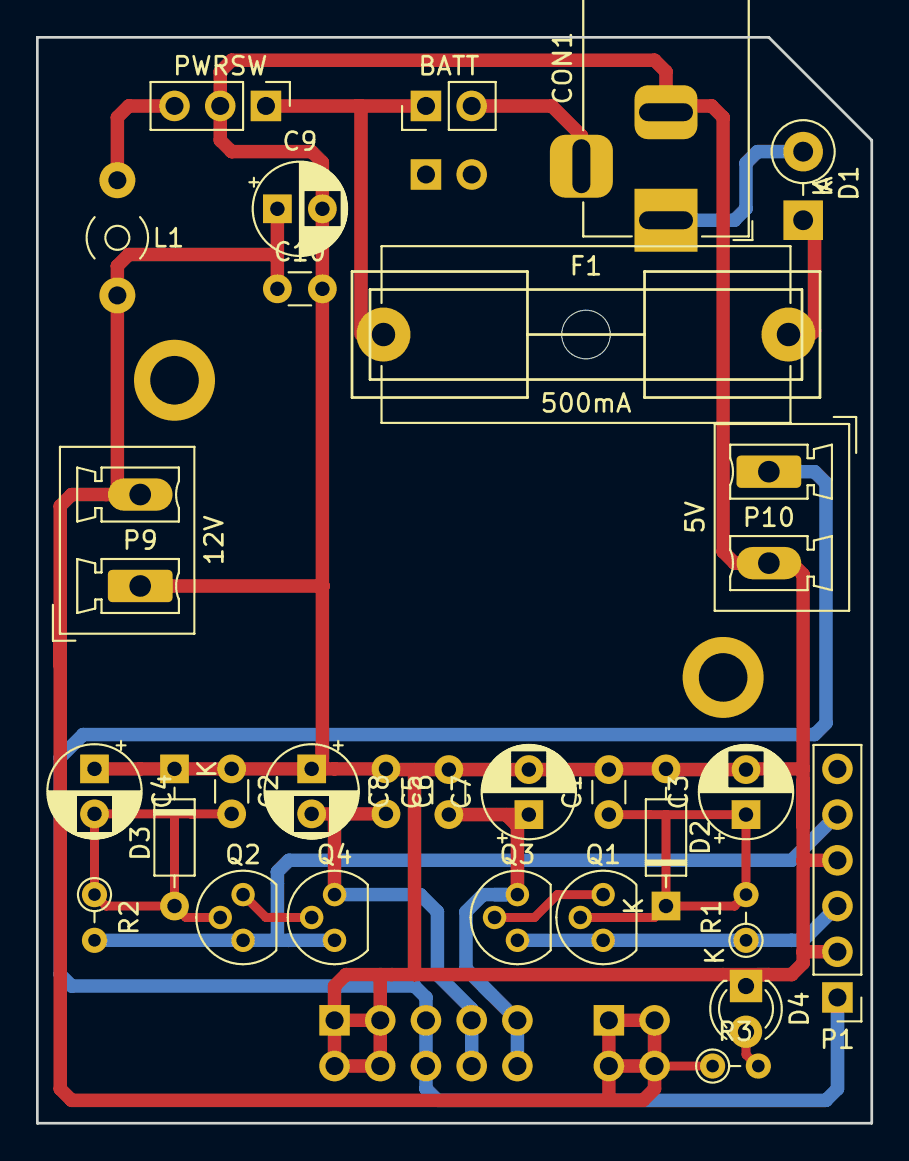
[picture p18: board yatabaza-power.kicad_pcb from above]

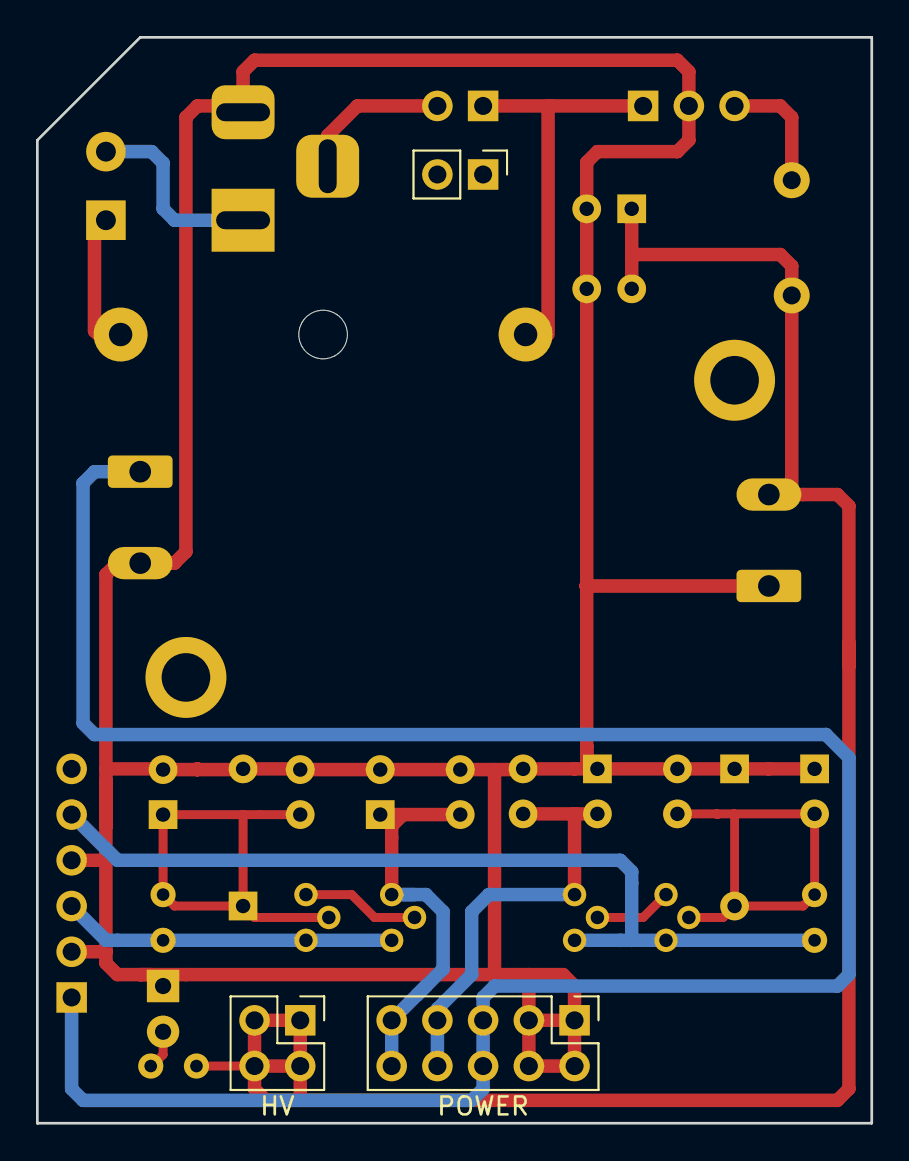
[picture p19: board yatabaza-power.kicad_pcb from below]

Board: 2 copper layers, 46.4 x 60.3 mm, 34 parts (3 on the bottom side), 17 nets.

Parts:
C1, C2, C5, C6, C10: 100n; C_Disc_D3.0mm_W1.6mm_P2.50mm
C3, C4, C7, C8, C9: 100u; CP_Radial_D5.0mm_P2.50mm
CON1: POWER; BarrelJack_Horizontal
D1: 1n4007; D_DO-41_SOD81_P3.81mm_Vertical_KathodeUp
D2, D3: 12V; D_DO-35_SOD27_P7.62mm_Horizontal
D4: LED; LED_D3.0mm
F1: 500mA; Fuseholder_Cylinder-5x20mm_Schurter_0031_8201_Horizontal_Op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
L1: 100uH; L_Toroid_Horizontal_D3.2mm_P6.40mm_Diameter3-5mm_Amidon-T12
P1: DCDC_DUAL; PinHeader_1x06_P2.54mm_Vertical
P2: BATT; PinHeader_1x02_P2.54mm_Vertical
P3: PWRSW; PinHeader_1x03_P2.54mm_Vertical
P4: POWER; PinHeader_2x05_P2.54mm_Vertical
P5: HV; PinHeader_2x02_P2.54mm_Vertical
P6: SUPPORT; PinHeader_1x02_P2.54mm_Vertical
P7, P8: SCREW; MountingHole_2.7mm_M2.5_ISO14580_Pad
P9: 12V; PhoenixContact_MCV_1,5_2-G-5.08_1x02_P5.08mm_Vertical
P10: 5V; PhoenixContact_MCV_1,5_2-G-5.08_1x02_P5.08mm_Vertical
Q1, Q3: BC338; TO-92
Q2, Q4: BC328; TO-92
R1, R2, R3: 1k; R_Axial_DIN0204_L3.6mm_D1.6mm_P2.54mm_Vertical

Connections:
+5V: P1.1, P4.5, P4.6, P10.1
+9VA: C5.1, C7.1, P4.9, P4.10, Q3.3 (E)
+12V: C9.1, C10.1, L1.2, P5.1, P5.2, P5.3, P5.4, P9.2, R3.1
-9VA: C6.2, C8.2, P4.7, P4.8, Q4.3 (E)
GND: C1.2, C2.1, C3.2, C4.1, C5.2, C6.1, C7.2, C8.1, C9.2, C10.2, CON1.2, D2.2 (A), D3.1 (K), D4.1 (K), P1.2, P1.4, P3.2, P4.1, P4.2, P4.3, P4.4, P9.1, P10.2
unnamed: C1.1, C3.1, D2.1 (K), Q1.2 (B), R1.2
unnamed: C2.2, C4.2, D3.2 (A), Q2.2 (B), R2.1
unnamed: CON1.1, D1.2 (A)
unnamed: CON1.3, P2.2
unnamed: D1.1 (K), F1.1
unnamed: P1.3, Q1.1 (C), Q3.1 (C), R1.1
unnamed: P1.5, Q2.1 (C), Q4.1 (C), R2.2
unnamed: F1.2, P2.1, P3.1
unnamed: L1.1, P3.3
unnamed: Q2.3 (E), Q4.2 (B)
unnamed: Q1.3 (E), Q3.2 (B)
unnamed: D4.2 (A), R3.2
