ycwn/yatabaza/hardware/cpu/yatabaza-cpu.kicad_pcb

## KiCad design hardware/cpu/yatabaza-cpu.kicad_pcb (2022-04-23)

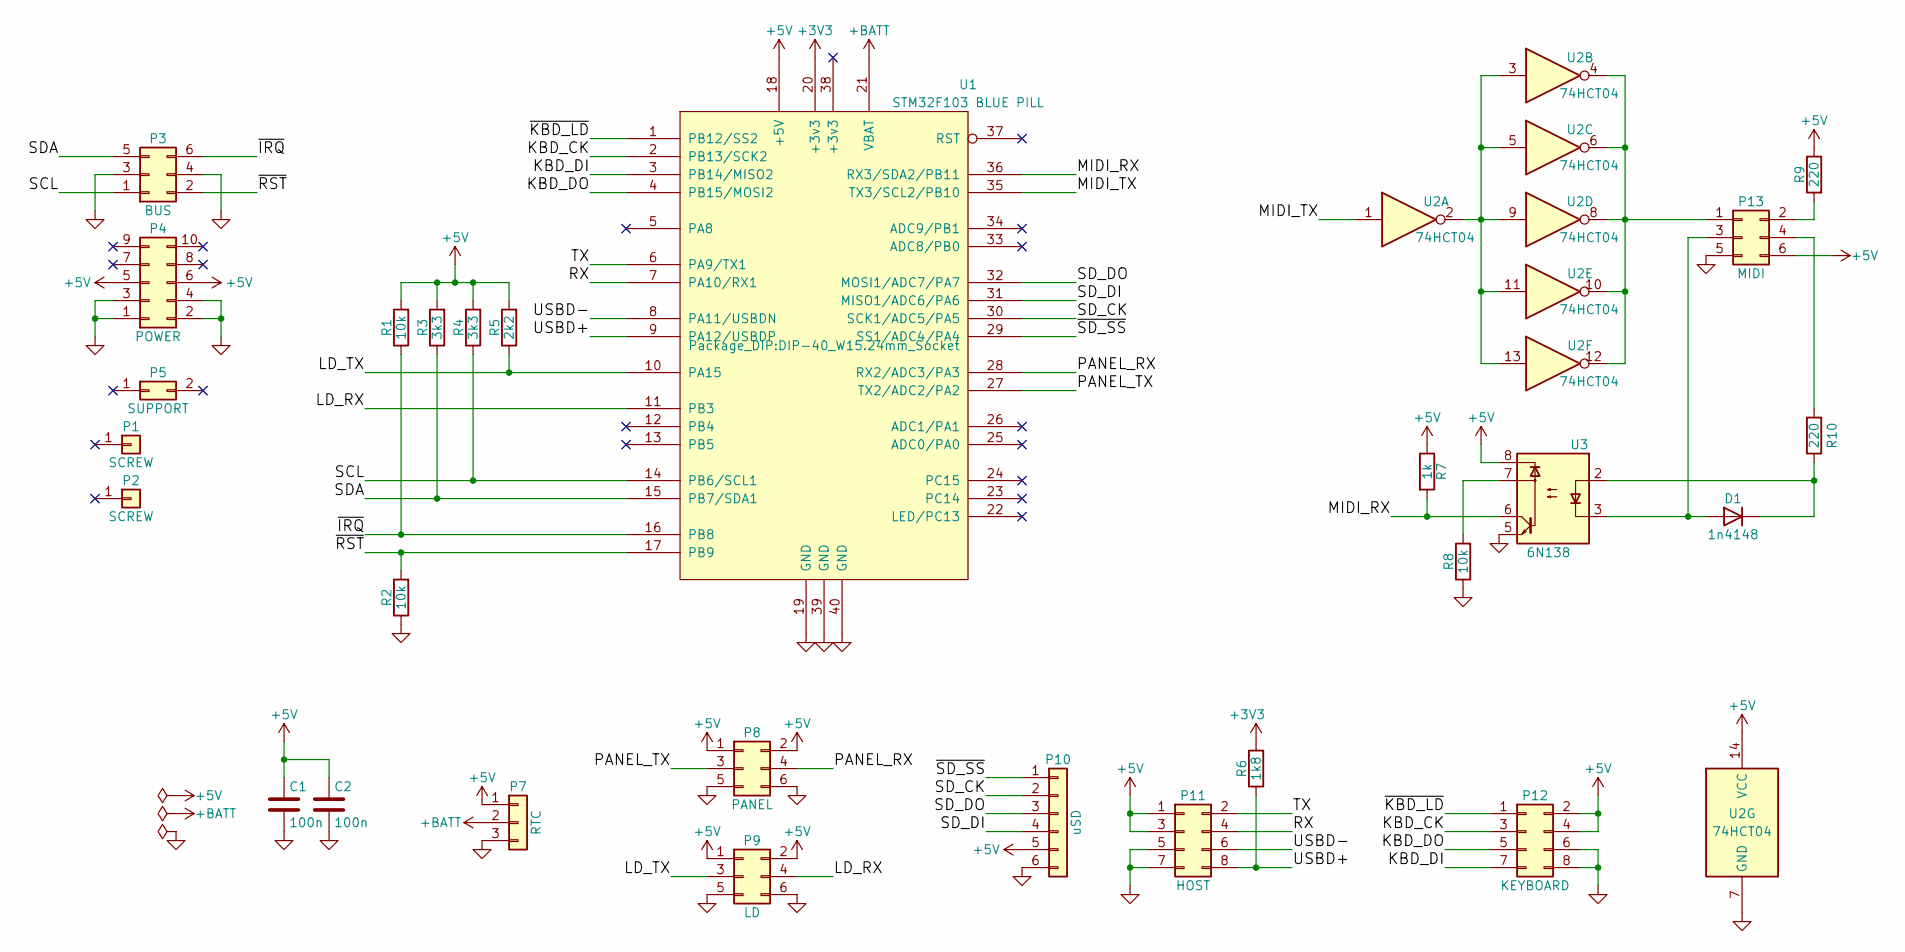
[picture p20: schematic yatabaza-cpu.kicad_sch]

Parts:
C1, C2: 100n; C_Disc_D3.0mm_W1.6mm_P2.50mm
D1: 1n4148; D_DO-35_SOD27_P2.54mm_Vertical_KathodeUp
P1, P2: SCREW; MountingHole_2.2mm_M2_ISO14580_Pad
P3: BUS; PinHeader_2x03_P2.54mm_Vertical
P4: POWER; PinHeader_2x05_P2.54mm_Vertical
P5: SUPPORT; PinHeader_1x02_P2.54mm_Vertical
P7: RTC; PinHeader_1x03_P2.54mm_Vertical
P8: PANEL; PinHeader_2x03_P2.54mm_Vertical
P9: LD; PinHeader_2x03_P2.54mm_Vertical
P10: uSD; PinHeader_1x06_P2.54mm_Vertical
P11: HOST; PinHeader_2x04_P2.54mm_Vertical
P12: KEYBOARD; PinHeader_2x04_P2.54mm_Horizontal
P13: MIDI; PinHeader_2x03_P2.54mm_Vertical
R1, R2, R8: 10k; R_Axial_DIN0204_L3.6mm_D1.6mm_P7.62mm_Horizontal
R3, R4: 3k3; R_Axial_DIN0204_L3.6mm_D1.6mm_P7.62mm_Horizontal
R5: 2k2; R_Axial_DIN0204_L3.6mm_D1.6mm_P2.54mm_Vertical
R6: 1k8; R_Axial_DIN0204_L3.6mm_D1.6mm_P7.62mm_Horizontal
R7: 1k; R_Axial_DIN0204_L3.6mm_D1.6mm_P7.62mm_Horizontal
R9, R10: 220; R_Axial_DIN0204_L3.6mm_D1.6mm_P2.54mm_Vertical
U1: STM32F103 BLUE PILL; DIP-40_W15.24mm_Socket
U2: 74HCT04; DIP-14_W7.62mm
U3: 6N138; DIP-8_W7.62mm

Connections:
+3V3: R6.2, U1.20 (+3v3)
+5V: C1.1, C2.1, P4.5, P4.6, P7.1, P8.1, P8.2, P9.1, P9.2, P10.5, P11.1, P11.3, P12.2, P12.4, P13.6, R1.2, R3.2, R4.2, R5.2, R7.1, R9.1, U1.18 (+5V), U2.14 (VCC), U3.8
+BATT: P7.2, U1.21 (VBAT)
/KBD_CK: P12.3, U1.2 (PB13/SCK2)
/KBD_DI: P12.7, U1.3 (PB14/MISO2)
/KBD_DO: P12.5, U1.4 (PB15/MOSI2)
/LD_RX: P9.4, U1.11 (PB3)
/LD_TX: P9.3, R5.1, U1.10 (PA15)
/MIDI_RX: R7.2, U1.36 (RX3/SDA2/PB11), U3.6
/MIDI_TX: U1.35 (TX3/SCL2/PB10), U2.1
/PANEL_RX: P8.4, U1.28 (RX2/ADC3/PA3)
/PANEL_TX: P8.3, U1.27 (TX2/ADC2/PA2)
/RX: P11.4, U1.7 (PA10/RX1)
/SCL: P3.1, R4.1, U1.14 (PB6/SCL1)
/SDA: P3.5, R3.1, U1.15 (PB7/SDA1)
/SD_CK: P10.2, U1.30 (SCK1/ADC5/PA5)
/SD_DI: P10.4, U1.31 (MISO1/ADC6/PA6)
/SD_DO: P10.3, U1.32 (MOSI1/ADC7/PA7)
/TX: P11.2, U1.6 (PA9/TX1)
/USBD+: P11.8, R6.1, U1.9 (PA12/USBDP)
/USBD-: P11.6, U1.8 (PA11/USBDN)
/~IRQ: P3.6, R1.1, U1.16 (PB8)
/~KBD_LD: P12.1, U1.1 (PB12/SS2)
/~RST: P3.2, R2.2, U1.17 (PB9)
/~SD_SS: P10.1, U1.29 (SS1/ADC4/PA4)
GND: C1.2, C2.2, P3.3, P3.4, P4.1, P4.2, P4.3, P4.4, P7.3, P8.5, P8.6, P9.5, P9.6, P10.6, P11.5, P11.7, P12.6, P12.8, P13.5, R2.1, R8.1, U1.19 (GND), U1.39 (GND), U1.40 (GND), U2.7 (GND), U3.5
unnamed: D1.1 (K), R10.1, U3.2
unnamed: D1.2 (A), P13.3, U3.3
unnamed: P13.1, U2.4, U2.6, U2.8, U2.10, U2.12
unnamed: P13.2, R9.2
unnamed: P13.4, R10.2
unnamed: R8.2, U3.7
unnamed: U2.2, U2.3, U2.5, U2.9, U2.11, U2.13

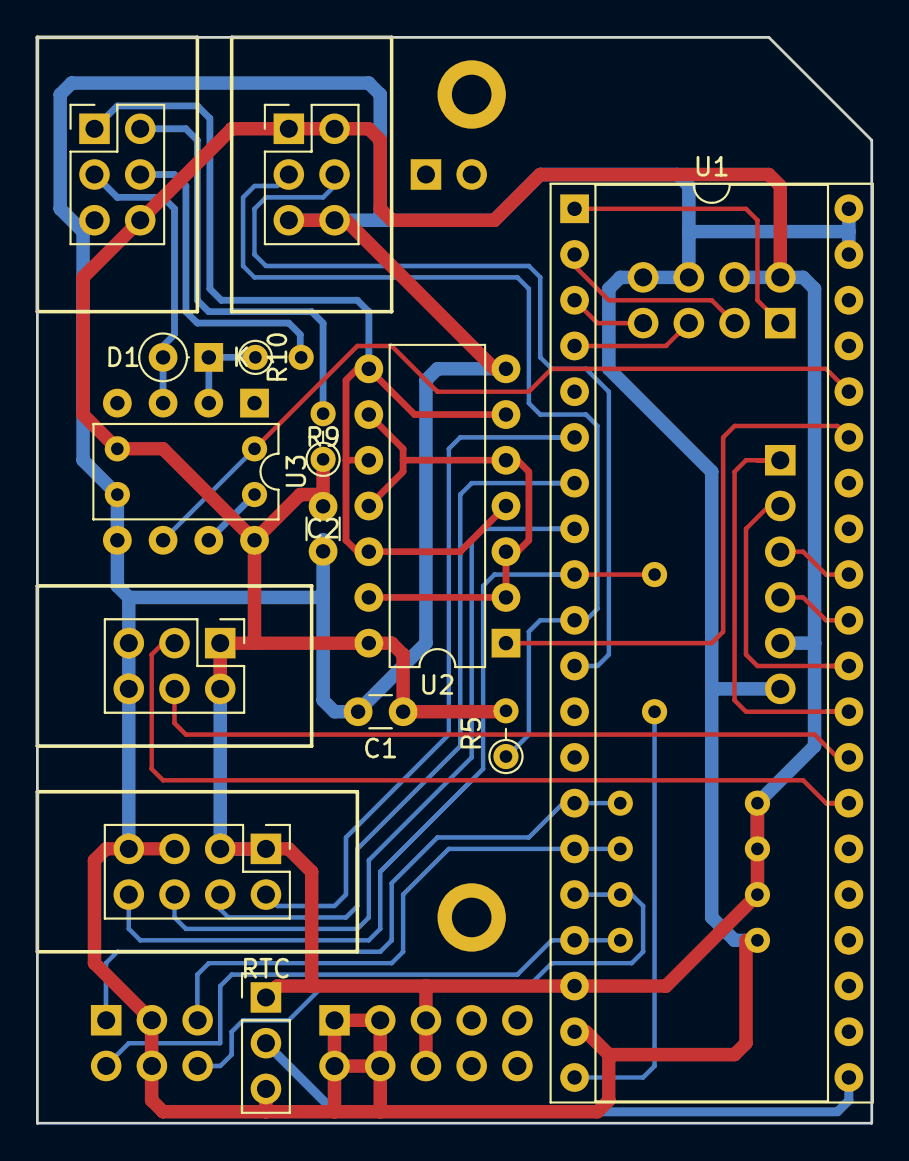
[picture p21: board yatabaza-cpu.kicad_pcb from above]

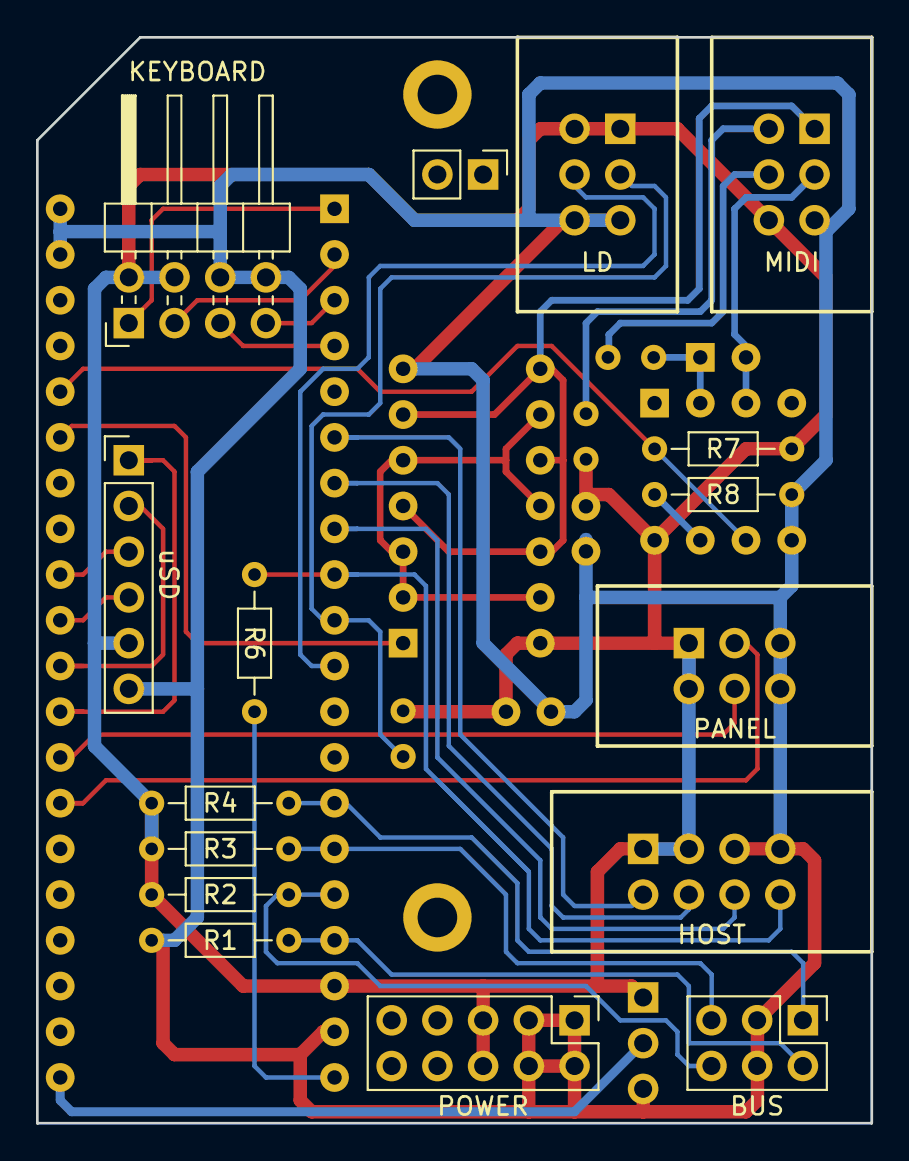
[picture p22: board yatabaza-cpu.kicad_pcb from below]

Board: 2 copper layers, 46.4 x 60.3 mm, 28 parts (12 on the bottom side), 33 nets.
