ycwn/yatabaza/src/core/debug.h

#ifndef CORE_DEBUG_H
#define CORE_DEBUG_H


#undef checkpoint
#undef assert
#undef watch


#ifdef DEBUG

#define checkpoint() \
	do { \
		printk("%s, %d: check!\n", __FILE__, __LINE__); \
	} while (0)

#define assert(pred) \
	do { \
		if (!(pred)) \
			printk("%s, %d: assertion '%s' failed!\n", __FILE__, __LINE__, #pred); \
	} while (0)

#define watch(format, var...) \
	do { \
		printk("%s, %d: %s = " format "\n", __FILE__, __LINE__, #var, var); \
	} while(0)

#else

#define checkpoint() { }    do { /* Nothing */ } while (0)
#define assert(pred) { }    do { /* Nothing */ } while (0)
#define watch(format, ...)  do { /* Nothing */ } while (0)


#endif



#endif
