ycwn/yatabaza/src/core/types.h

#ifndef CORE_TYPES_H
#define CORE_TYPES_H


typedef unsigned int uint;

typedef int8_t   i8;
typedef int16_t  i16;
typedef int32_t  i32;
typedef int64_t  i64;

typedef uint8_t   u8;
typedef uint16_t  u16;
typedef uint32_t  u32;
typedef uint64_t  u64;


#endif
