ycwn/yatabaza/(commit log)

2021-04-18 ~ Added schematic symbols
2021-04-18 ~ YM3812 Synthesizer board
    [yatabaza-synth.kicad_pcb, yatabaza-synth.sch]
2021-04-18 ~ STM32F103C8T6 CPU board
    [yatabaza-cpu.kicad_pcb, yatabaza-cpu.sch]
2021-04-18 ~ Main bus interconnect.
    [yatabaza-bus.kicad_pcb, yatabaza-bus.sch]
2021-04-18 ~ Power supply board.
    [yatabaza-power-B.SilkS.dxf, yatabaza-power-F.SilkS.dxf, yatabaza-power.kicad_pcb, yatabaza-power.sch]
2021-04-18 ~ XH-M228 power amplifier board.
    [yatabaza-amp.kicad_pcb, yatabaza-amp.sch]
2021-04-20 ~ Device interface
2021-04-20 ~ Loopback device
2021-04-20 ~ Synth bus driver.
2021-05-01 ~ Fixed flags passed to open() in creat() ~ Added the bus as dependency to the scanner service
    [device.c, scanner.c]
2021-05-02 ~ Fixed header guards
    [bus.h, console.h, debug.h, device.h, kernel.h, opl_io.h, service.h, types.h]
2021-09-02 ~ Fixed buggy MIDI event decoder
    [midi.c]
2021-09-02 ~ Added MIDI channel filter mask
2021-09-02 ~ Use a state-machine to track SysEx events
2021-09-02 ~ Implemented MIDI I/O device
2022-04-23 ~ Ported hardware to Kicad6
    [yatabaza-amp.kicad_pcb, yatabaza-amp.kicad_sch, yatabaza-amp.sch, yatabaza-bus.kicad_pcb, yatabaza-bus.kicad_sch, yatabaza-bus.sch, yatabaza-cpu.kicad_pcb, yatabaza-cpu.kicad_sch]
2022-04-23 ~ Added gerbers and schematics
    [yatabaza-amp-B_Cu.gbl, yatabaza-amp-B_Mask.gbs, yatabaza-amp-B_Paste.gbp, yatabaza-amp-B_Silkscreen.gbo, yatabaza-amp-Edge_Cuts.gm1, yatabaza-amp-F_Cu.gtl, yatabaza-amp-F_Mask.gts, yatabaza-amp-F_Paste.gtp]
2022-04-23 ~ Added mechanical drawing of basic board
2022-05-02 ~ Added design for keyboard part
    [yatabaza-keyboard-B_Cu.gbl, yatabaza-keyboard-B_Mask.gbs, yatabaza-keyboard-B_Paste.gbp, yatabaza-keyboard-B_Silkscreen.gbo, yatabaza-keyboard-Edge_Cuts.gm1, yatabaza-keyboard-F_Cu.gtl, yatabaza-keyboard-F_Mask.gts, yatabaza-keyboard-F_Paste.gtp]
2022-05-03 ~ Change resistors to US style.
    [yatabaza-cpu.kicad_sch, yatabaza-power.kicad_sch, yatabaza-synth.kicad_sch]
